versioduo/connect/README.md

# Copying
Anyone can use this public domain work without having to seek authorisation, no one can ever own it.
