versioduo/connect/hardware/hub/hub.pdf

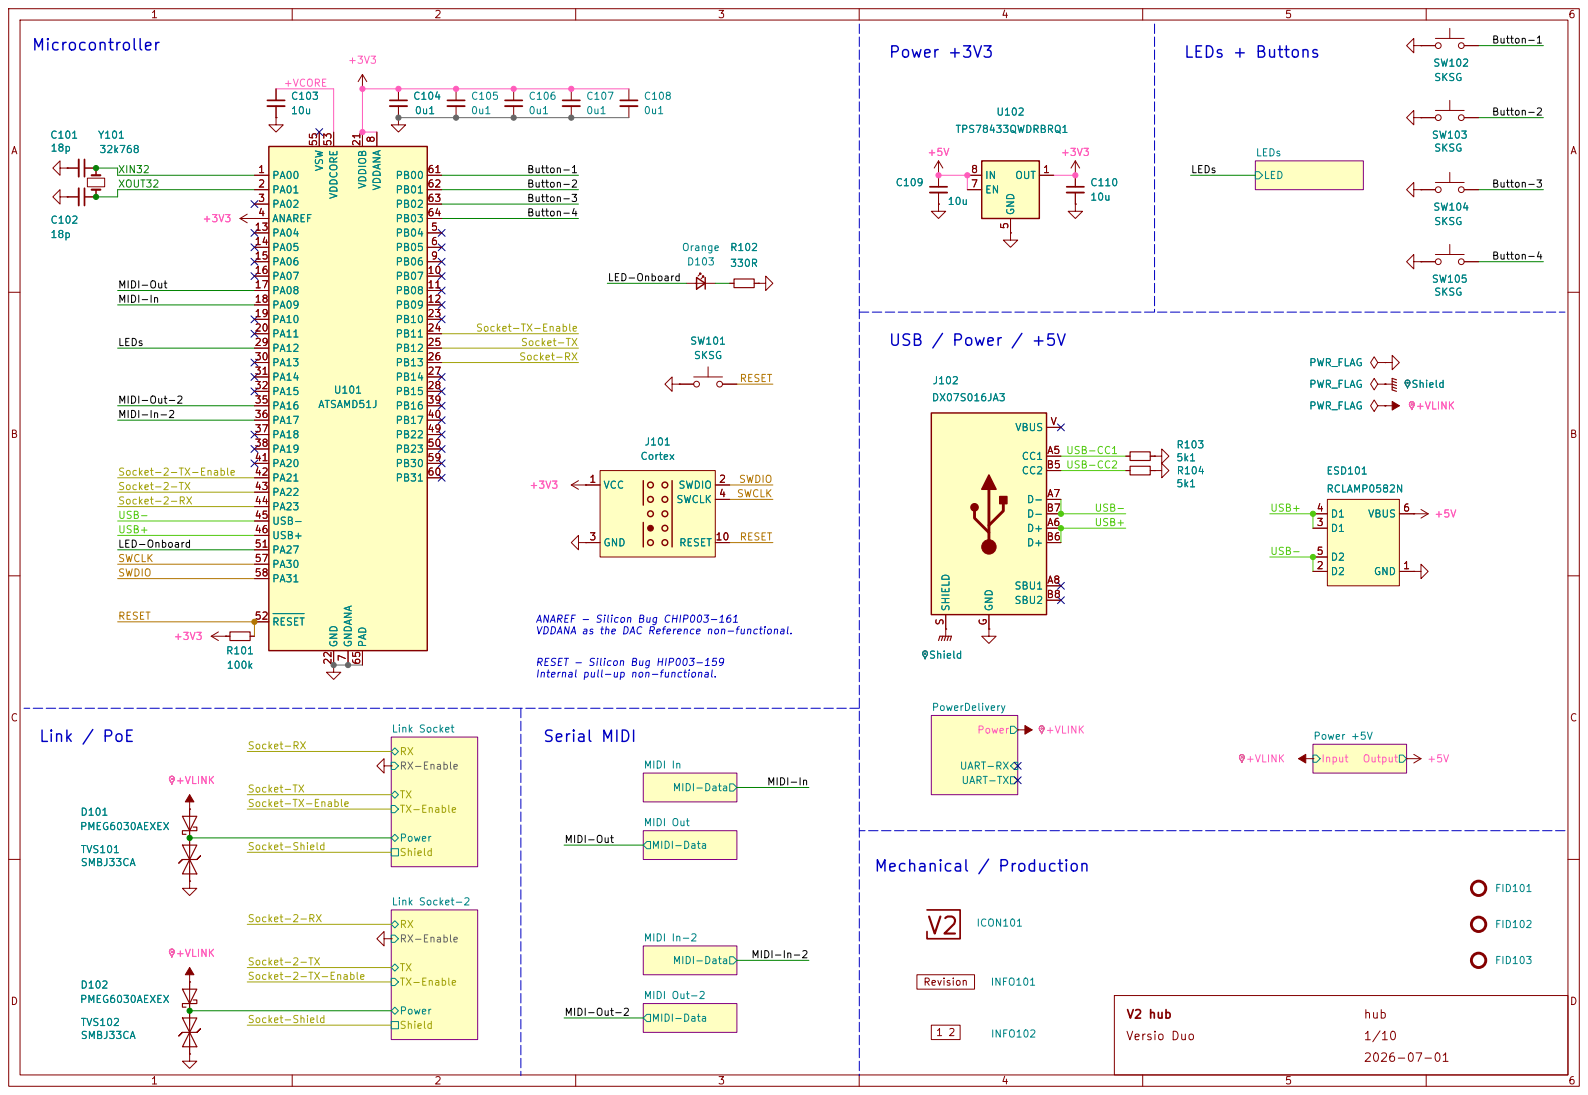
[picture p1: page 1]

RESET MIDI-In-2 MIDI-In

RESET SWDIO MIDI-Out-2 RESET MIDI-In-2

Internal pull-up non-functional. Link / PoE

Power UART-RX UART-TX PowerDelivery

Socket-Shield Socket-RX

Socket-Shield Socket-2-TX-Enable Socket-TX-Enable Socket-2-TX

TX-Enable Power Shield

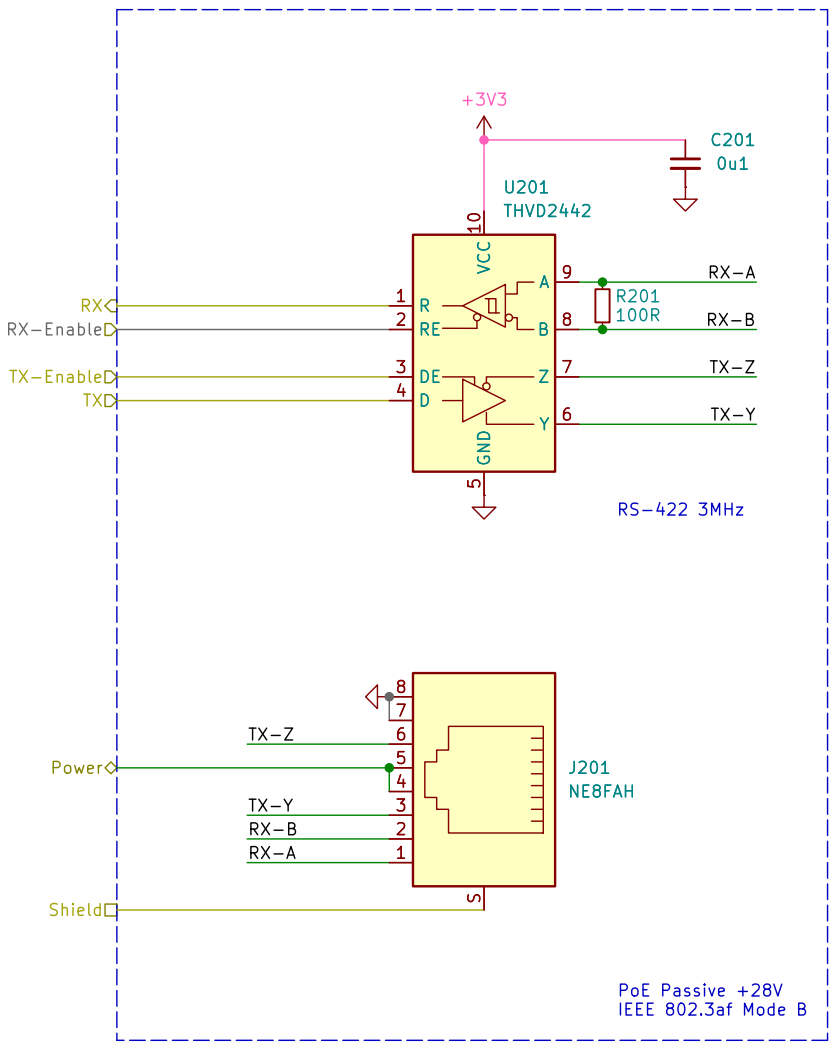
[picture p2: page 2]

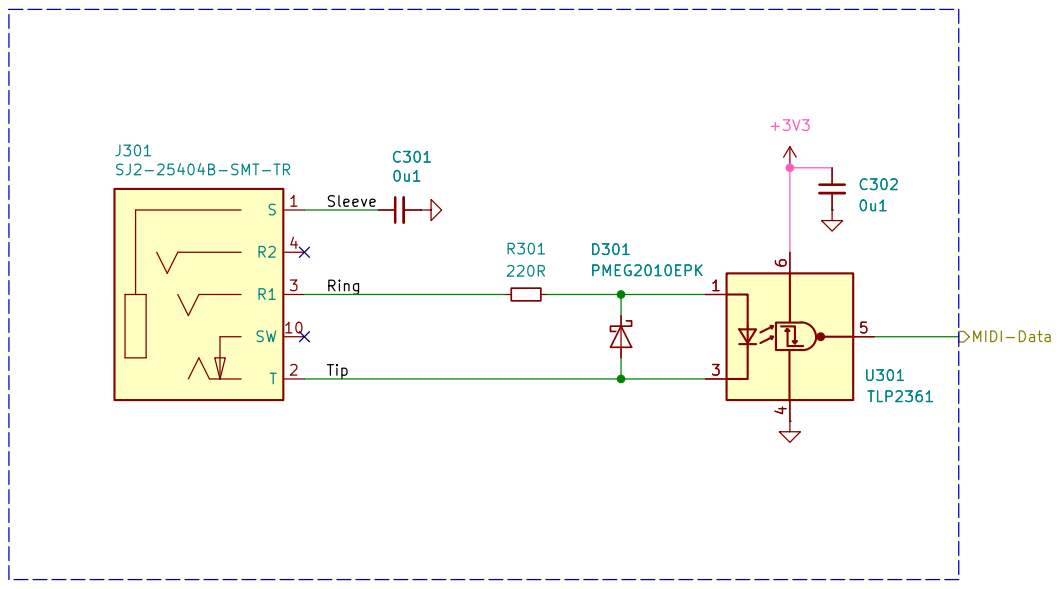
[picture p3: page 3]

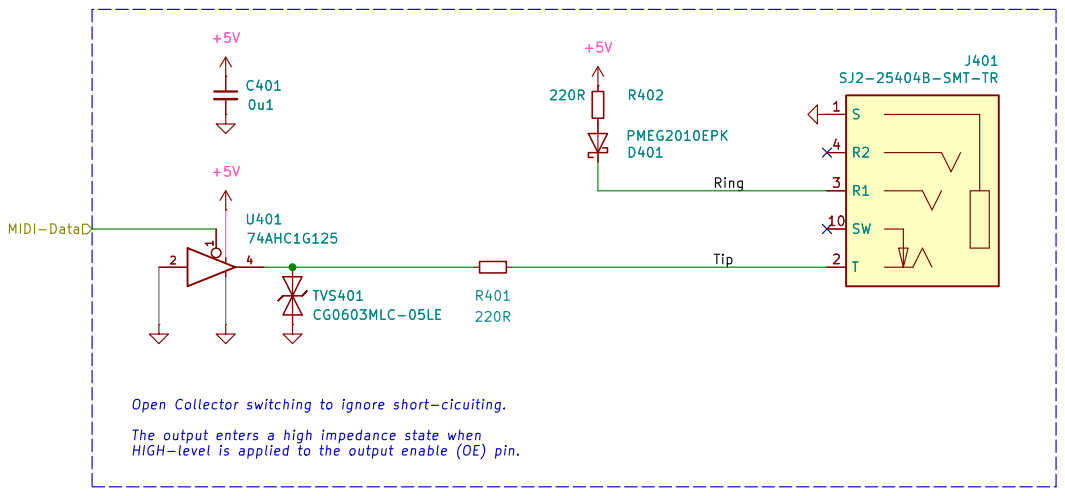
[picture p4: page 4]

Open Collector switching to ignore short-cicuiting. The output enters a high impedance state when HIGH-level is applied to the output enable (OE) pin. TVS401 CG0603MLC-05LE +5V +5V

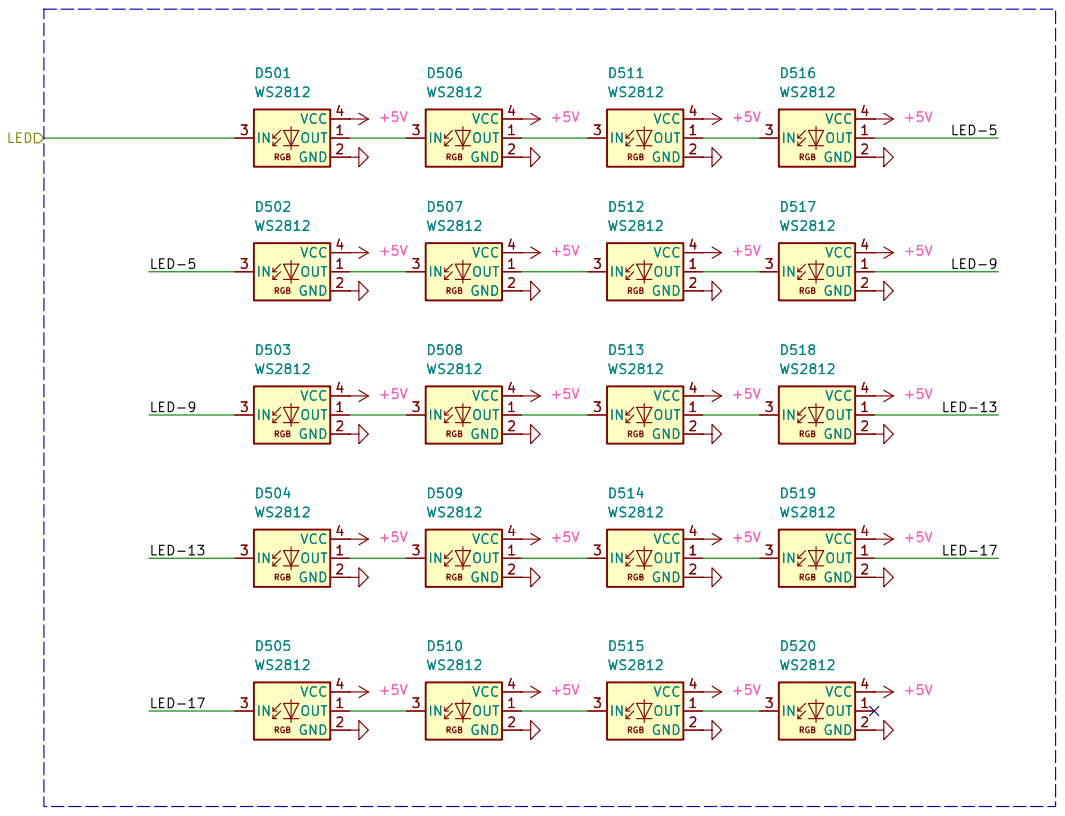
[picture p5: page 5]

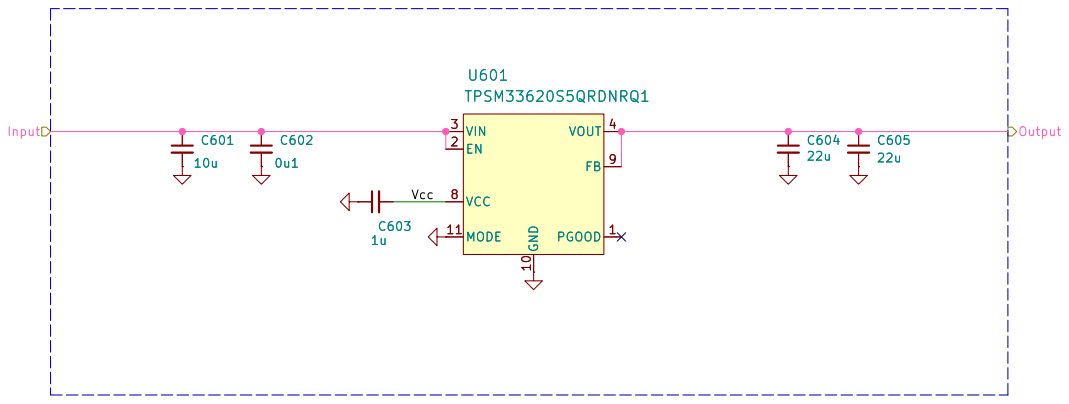
[picture p6: page 6]

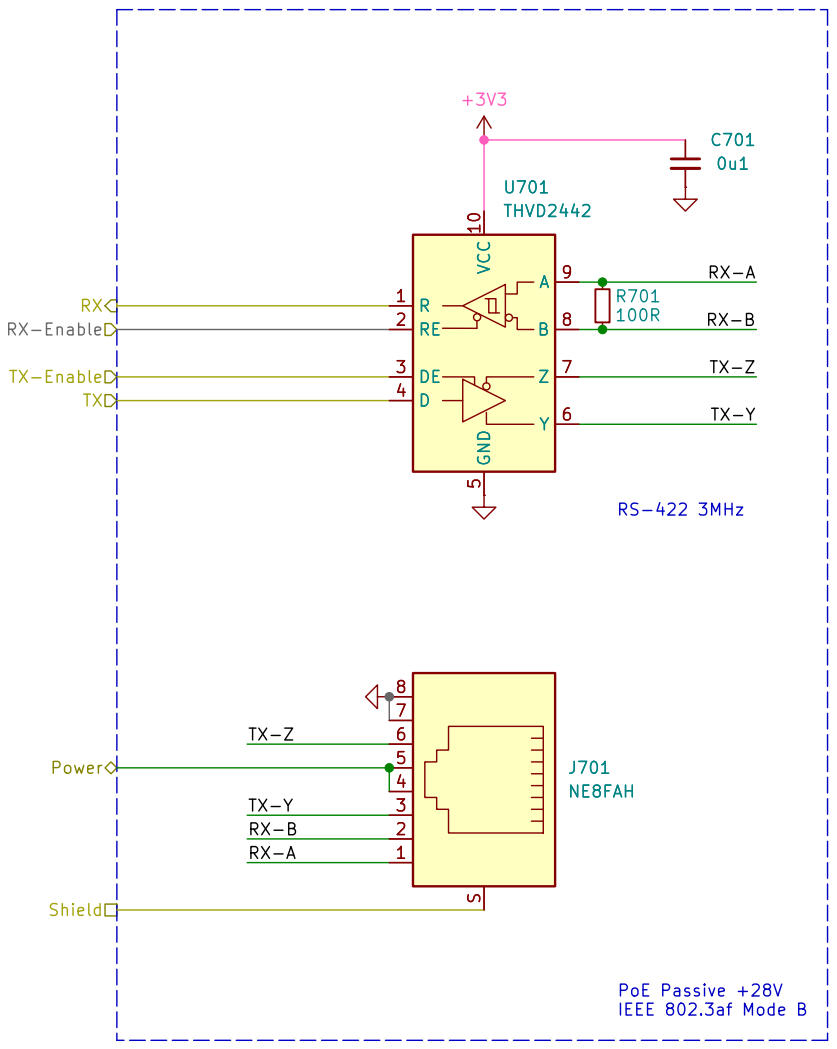
[picture p7: page 7]

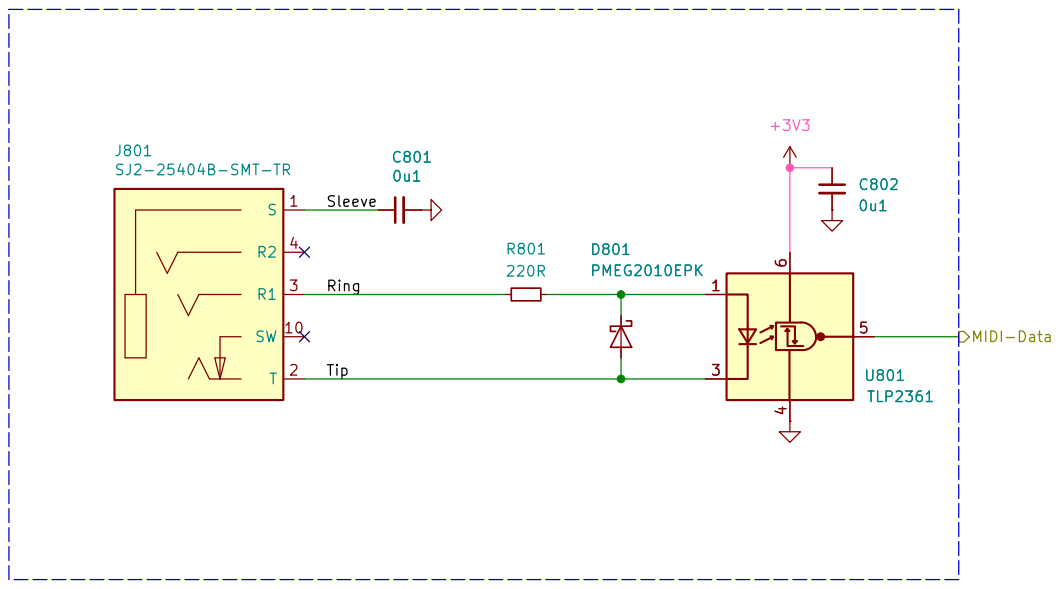
[picture p8: page 8]

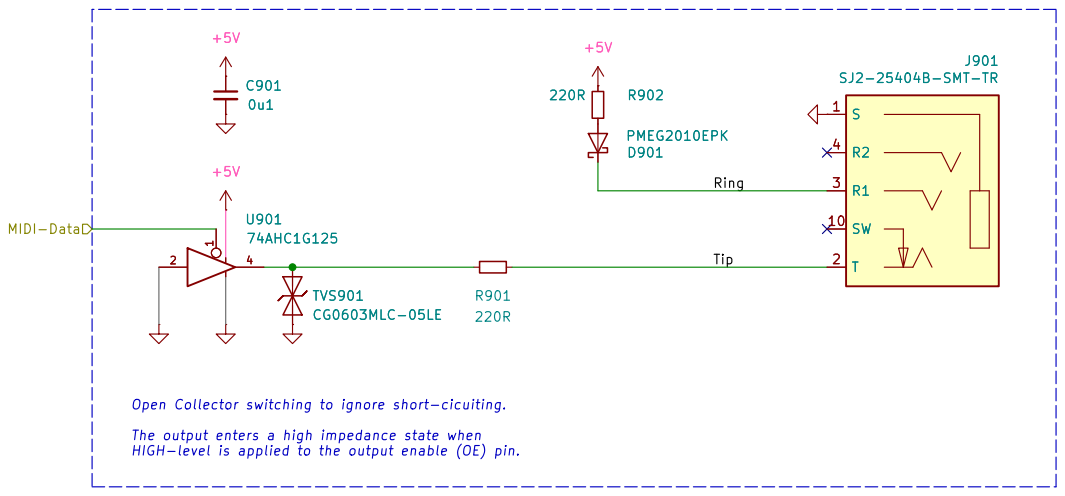
[picture p9: page 9]

Open Collector switching to ignore short-cicuiting. The output enters a high impedance state when HIGH-level is applied to the output enable (OE) pin. TVS901 CG0603MLC-05LE +5V +5V U901

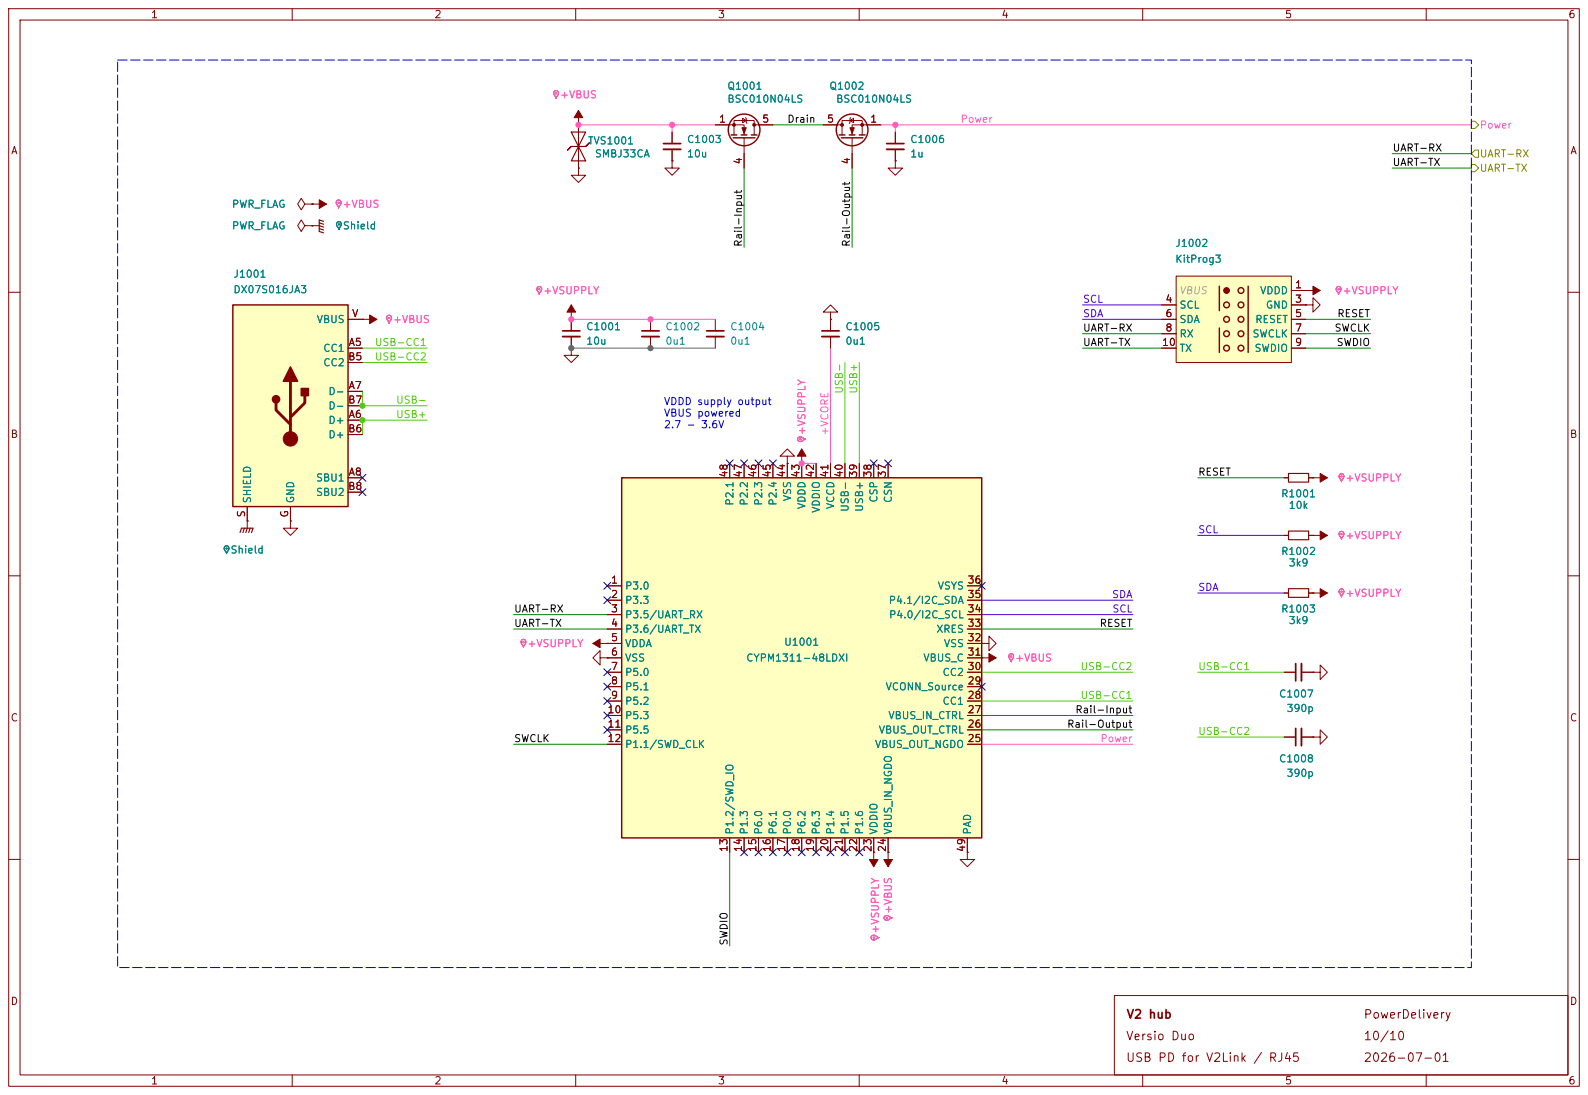
[picture p10: page 10]

PWR_FLAG +VBUS PWR_FLAG

SBU2 B8 GND
