versioduo/connect/hardware/plug/plug.pdf

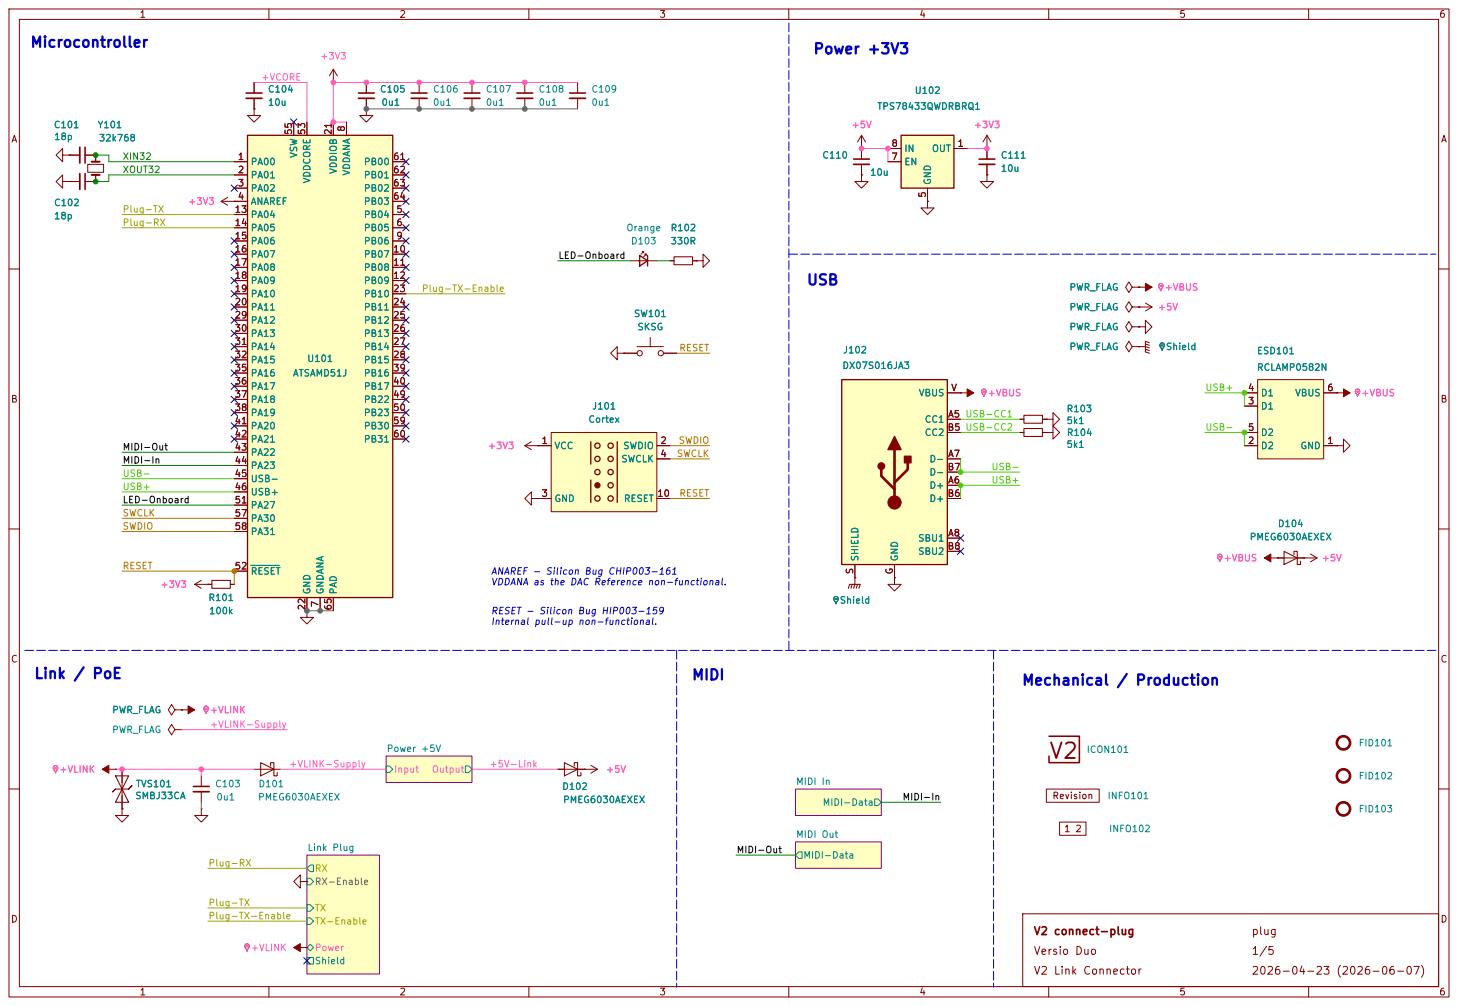
[picture p11: page 1]

Internal pull-up non-functional. ANAREF - Silicon Bug CHIP003-161

TX-Enable Power Shield

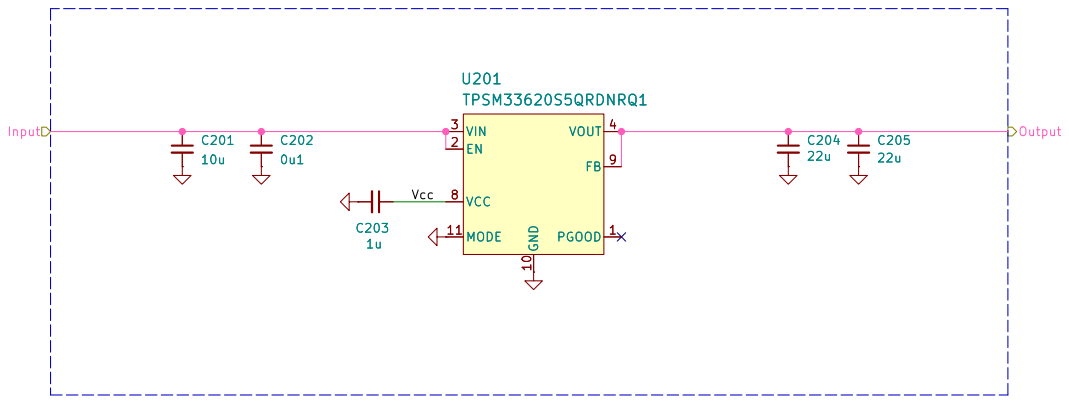
[picture p12: page 2]

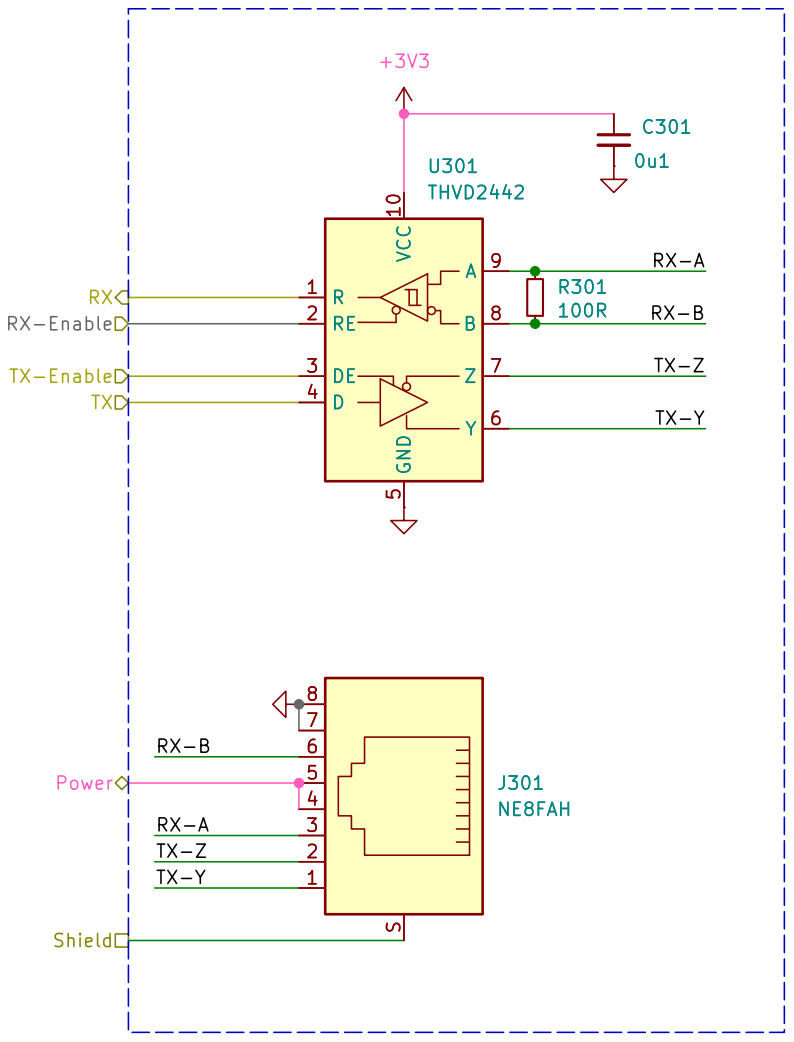
[picture p13: page 3]

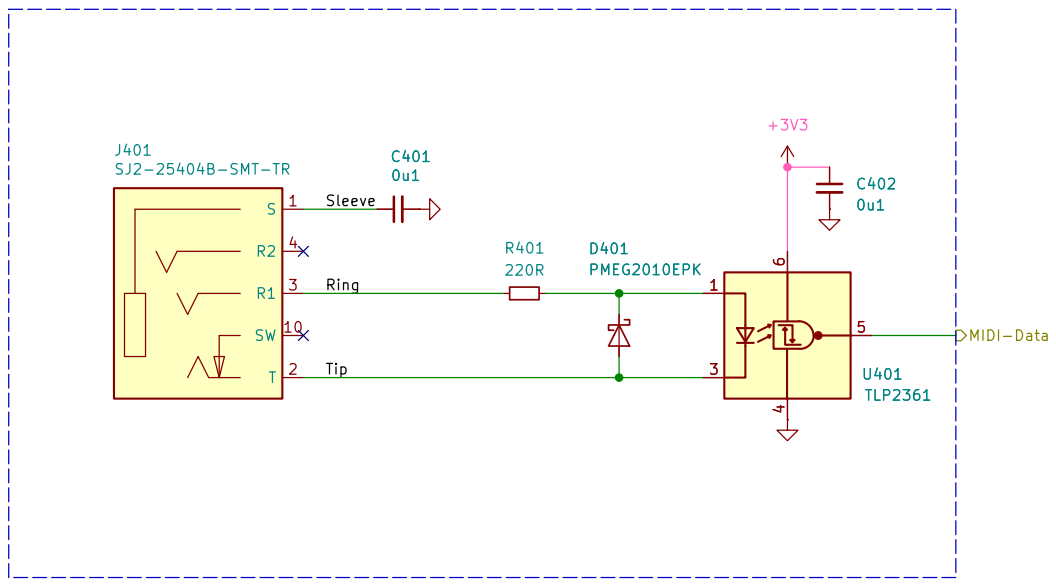
[picture p14: page 4]

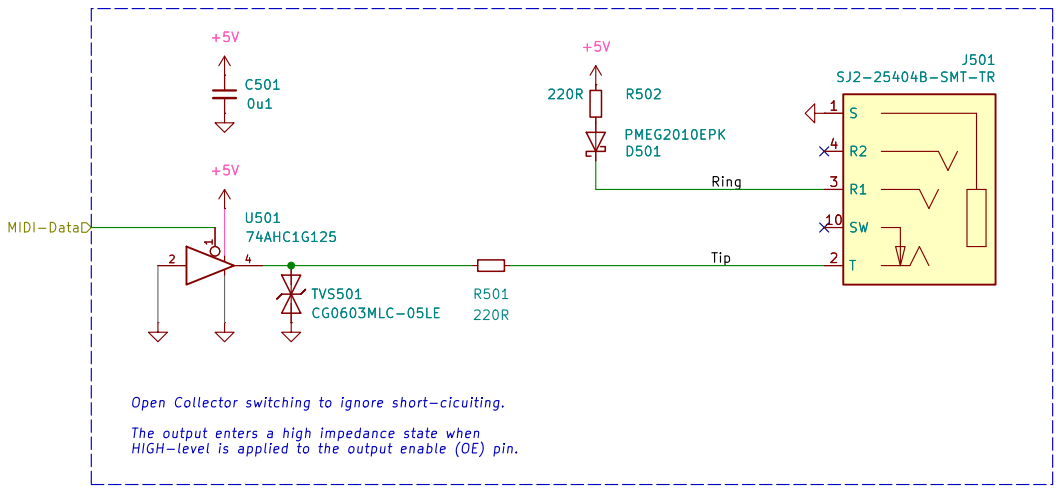
[picture p15: page 5]

Open Collector switching to ignore short-cicuiting. The output enters a high impedance state when HIGH-level is applied to the output enable (OE) pin. TVS501 CG0603MLC-05LE +5V +5V
