versioduo/connect/hardware/socket/socket.pdf

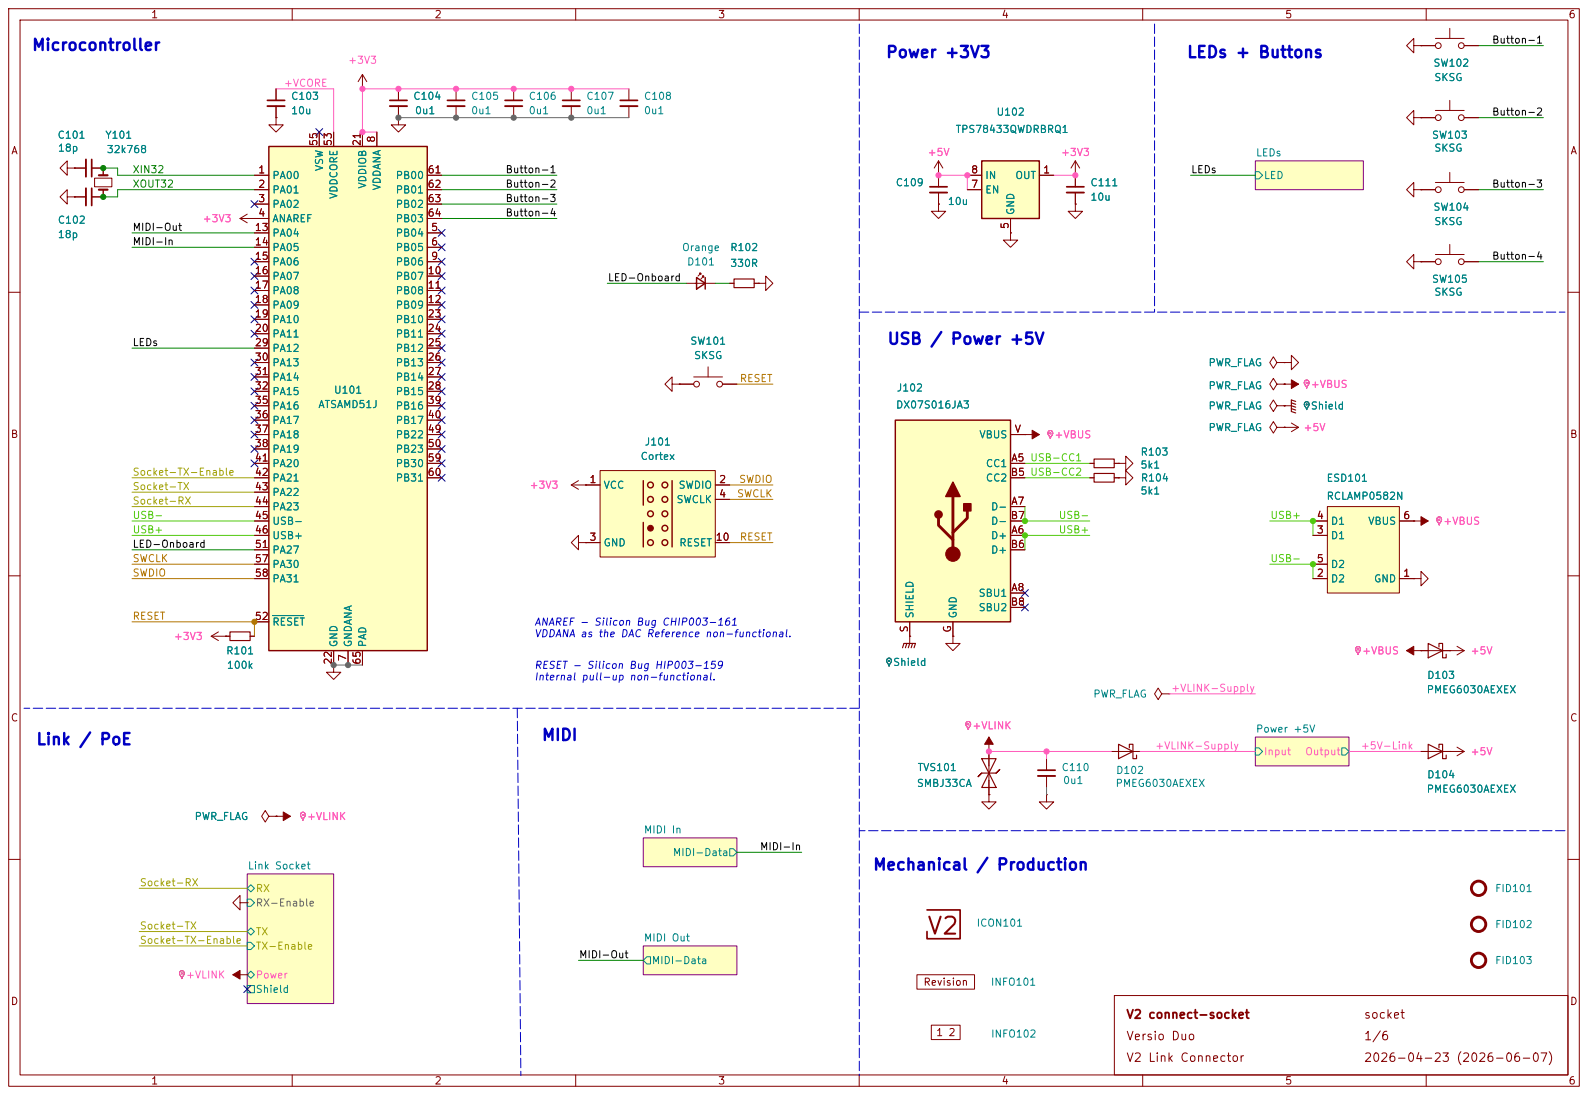
[picture p16: page 1]

+VLINK-Supply RESET MIDI-Out XOUT32

Internal pull-up non-functional. R101

MIDI RESET - Silicon Bug HIP003-159

socket MIDI-Data MIDI Out

TX-Enable Power Shield

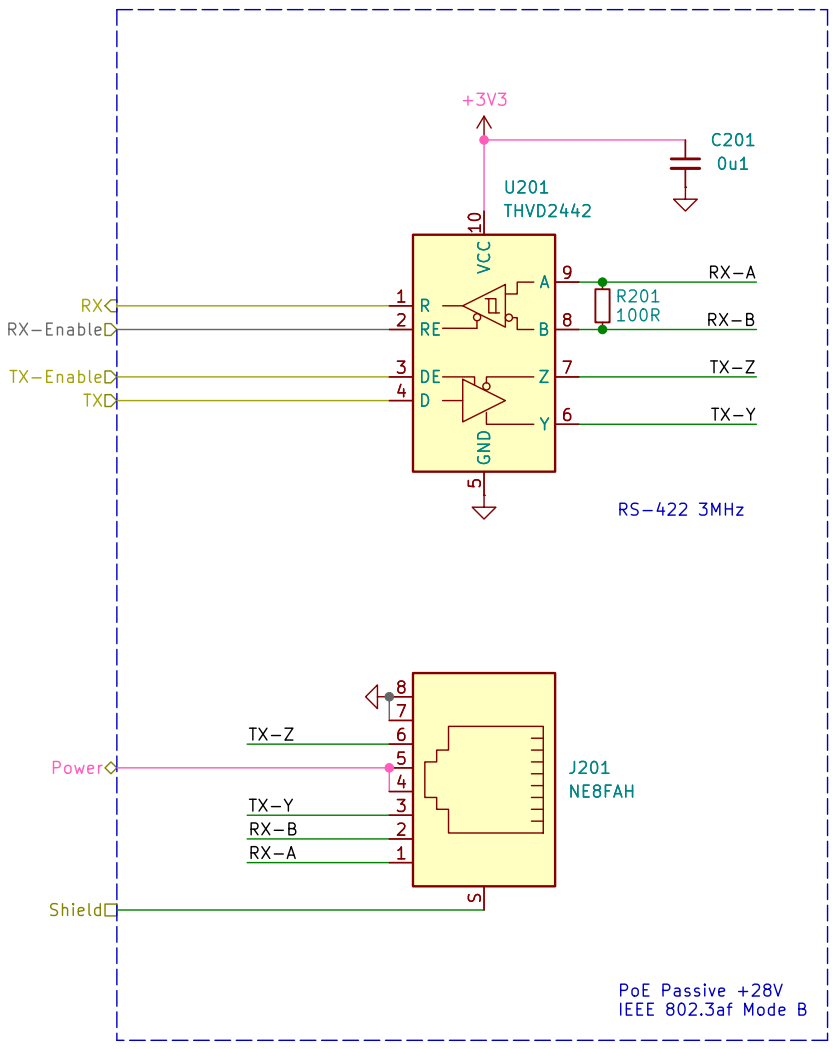
[picture p17: page 2]

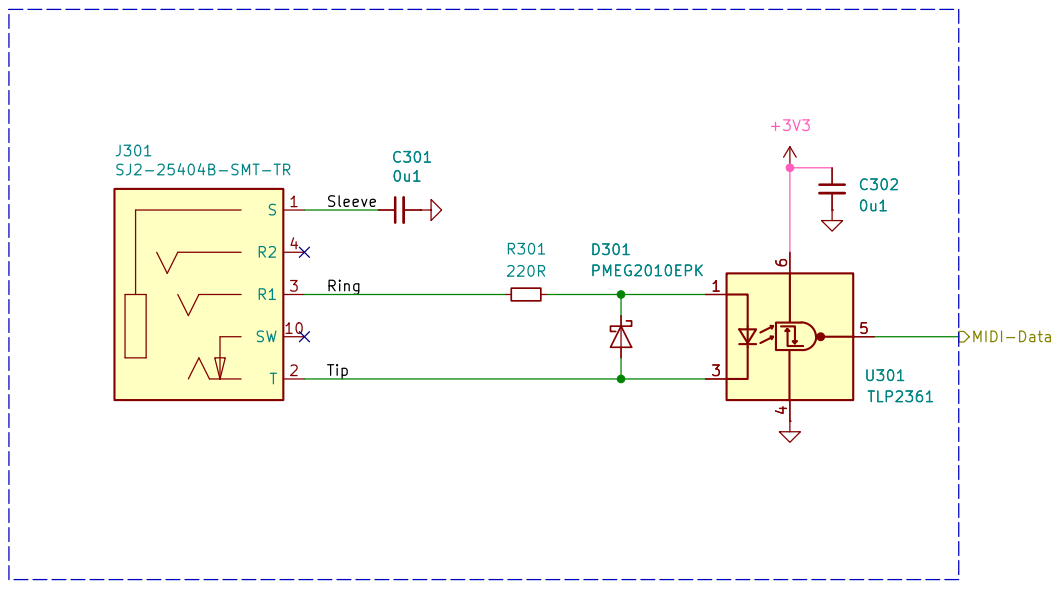
[picture p18: page 3]

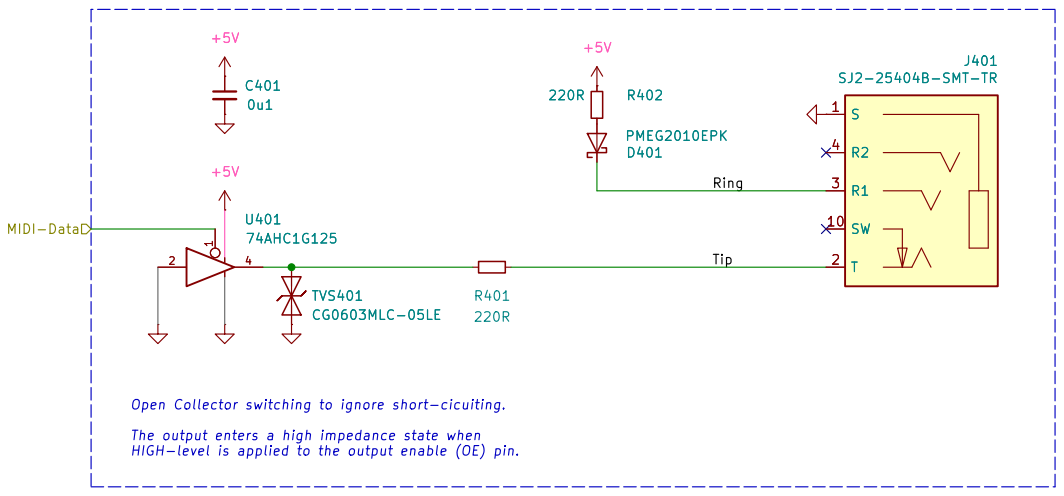
[picture p19: page 4]

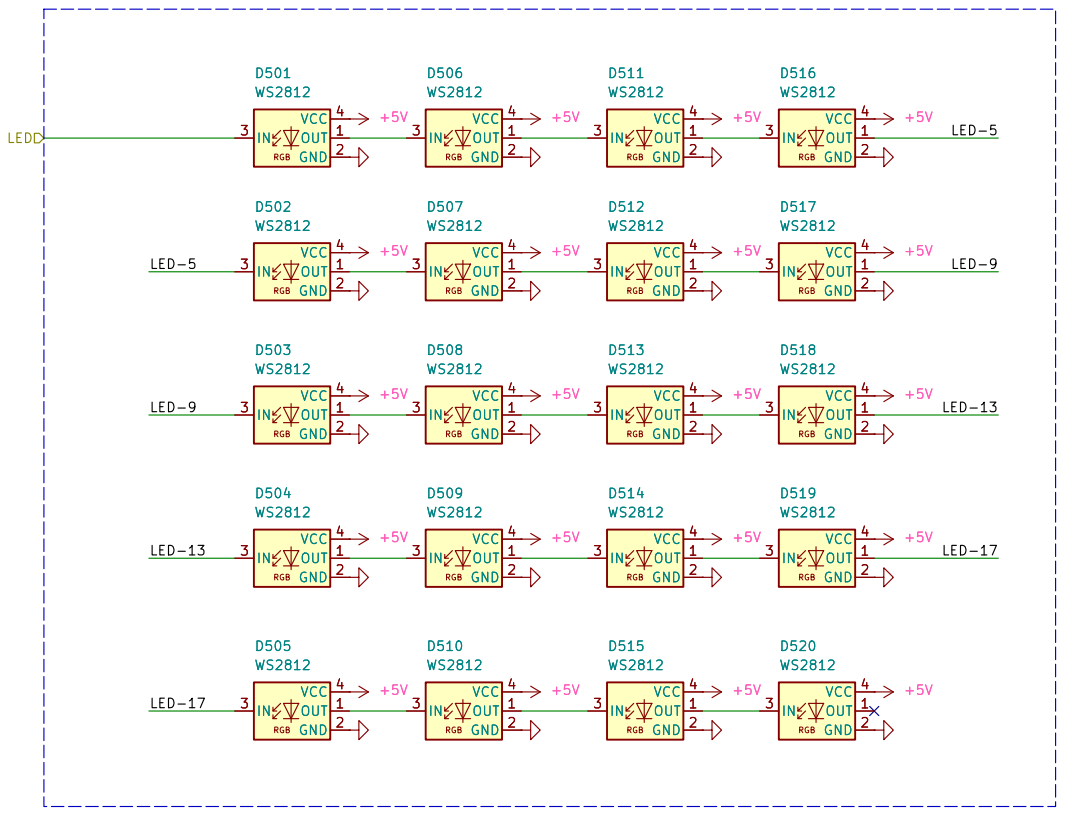
[picture p20: page 5]

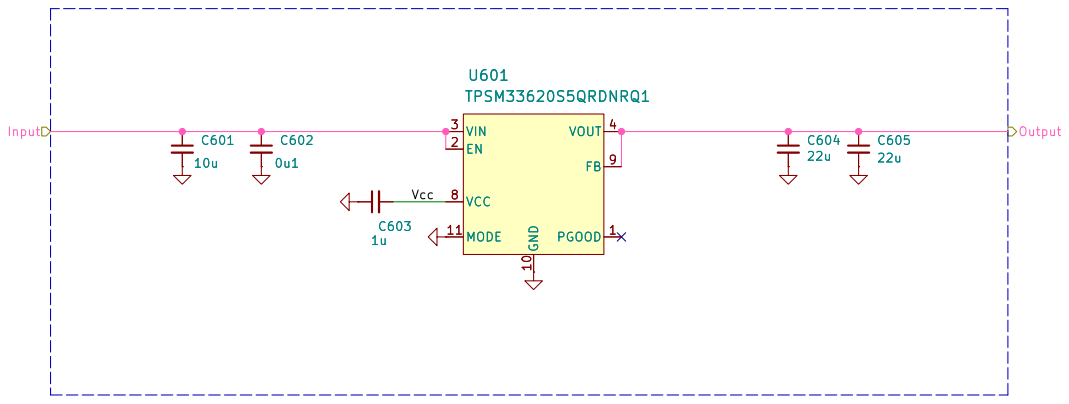
[picture p21: page 6]
