versioduo/connect/hardware/hub/hub.kicad_pcb

## KiCad design hardware/hub/hub.kicad_pcb (2026-08-01)

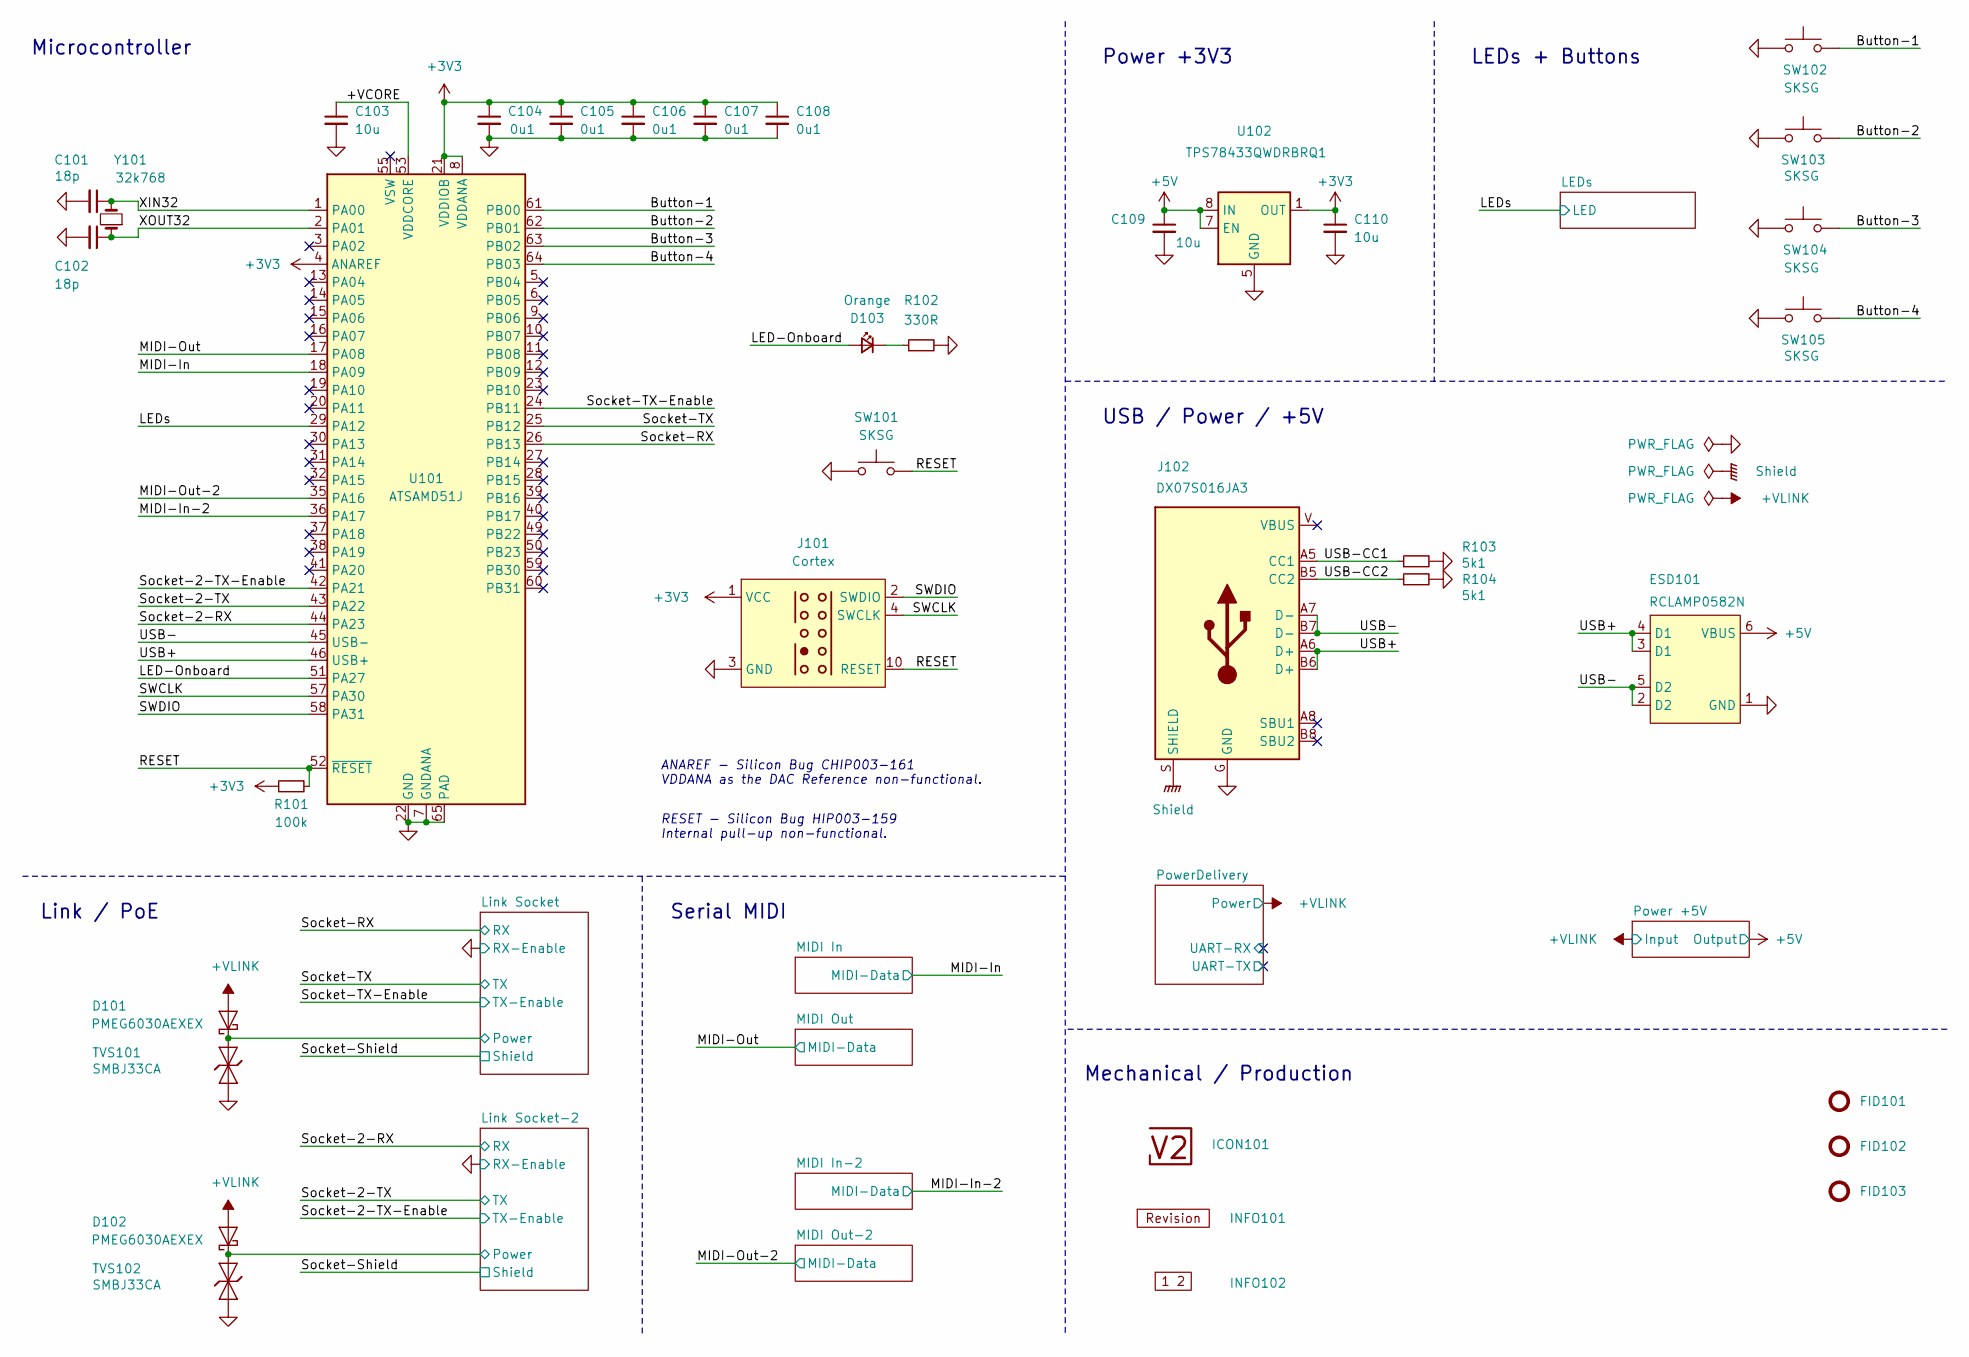
[picture p22: schematic hub.kicad_sch, V2 hub]

Parts:
C101, C102: 18p; C_1608; Rating 50V; Mouser 810-CGA3E2C0G1H180J
C103: 10u; C_1608; Rating 10V; Mouser 810-C1608X6S1A106M
C104, C105, C106, C107, C108: 0u1; C_1608; Rating 50V; Mouser 810-CGA3E2X7R1H104MA
C109, C110: 10u; C_2012; Rating 25V; Mouser 810-C2012X5R1E106K
D101, D102: PMEG6030AEXEX; D_SOD-123HP; Rating 60V; Mouser 771-PMEG6030AEXEX
D103: Orange; LED_1608; Rating 605nm; Mouser 755-SML-D12D1WT86
ESD101: RCLAMP0582N; SLP1210N6; Rating 20kV; Mouser 947-RCLAMP0582N.TCT
FID101, FID102, FID103: Fiducial_Paste; Fiducial_0.5mm_Mask1mm_Paste
ICON101: V2-logo; Logo_Small
INFO101: Revision
INFO102: Layer_Numbers-4
J101: Cortex
J102: DX07S016JA3; JAE_DX07S016JA3; Rating USB2.0; Mouser 656-DX07S016JA3R1500
R101: 100k; R_1608; Rating 100mW; Mouser 71-CRCW0603100KFKEAC
R102: 330R; R_1608; Rating 100mW; Mouser 71-CRCW0603330RFKEAC
R103, R104: 5k1; R_1608; Rating 100mW; Mouser 71-CRCW06035K10FKEAC
SW101, SW102, SW103, SW104, SW105: SKSG; Rating 1.6N; Mouser 688-SKSGACE010
TVS101, TVS102: SMBJ33CA; D_SMB; Rating 33V; Mouser 652-SMBJ33CA-Q
U101: ATSAMD51J; QFN-64-1EP_9x9mm_P0.5mm_EP4.8x4.8mm_ThermalVias; Rating Cortex-M4F; Mouser 556-ATSAMD51J19AMU
U102: TPS78433QWDRBRQ1; VSON-8-1_3x3mm_P0.65_EP1.65x2.4mm; Rating 300mA; Mouser 595-TPS78433QWDRBRQ1
Y101: 32k768; Crystal_SMD_3215-2Pin_3.2x1.5mm; Rating 10ppm; Mouser 815-ABS0716632.768KT

Connections:
+3V3: C104.1, C105.1, C106.1, C107.1, C108.1, C110.1, J101.1 (VCC), R101.1, U101.4 (ANAREF), U101.8 (VDDANA), U101.21 (VDDIOB), U101.34 (VDDIO), U101.48 (VDDIO), U101.56 (VDDIO), U102.1 (OUT); also elsewhere on the board
+5V: C109.1, ESD101.6 (VBUS), U102.7 (EN), U102.8 (IN); also elsewhere on the board
/+VCORE: C103.1, U101.53 (VDDCORE)
/+VLINK: D101.2 (A), D102.2 (A); also elsewhere on the board
/Button-1: SW102.2, U101.61 (PB00)
/Button-2: SW103.2, U101.62 (PB01)
/Button-3: SW104.2, U101.63 (PB02)
/Button-4: SW105.2, U101.64 (PB03)
/LED-Onboard: D103.2 (A), U101.51 (PA27)
/LEDs: U101.29 (PA12); also elsewhere on the board
/Link Socket-2/Power: D102.1 (K), TVS102.2 (A); also elsewhere on the board
/Link Socket/Power: D101.1 (K), TVS101.2 (A); also elsewhere on the board
/MIDI-In: U101.18 (PA09); also elsewhere on the board
/MIDI-In-2: U101.36 (PA17); also elsewhere on the board
/MIDI-Out: U101.17 (PA08); also elsewhere on the board
/MIDI-Out-2: U101.35 (PA16); also elsewhere on the board
/RESET: J101.10 (RESET), R101.2, SW101.2, U101.52 (~RESET)
/SWCLK: J101.4 (SWCLK), U101.57 (PA30)
/SWDIO: J101.2 (SWDIO), U101.58 (PA31)
/Shield: J102.S (SHIELD)
/Socket-2-RX: U101.44 (PA23); also elsewhere on the board
/Socket-2-TX: U101.43 (PA22); also elsewhere on the board
/Socket-2-TX-Enable: U101.42 (PA21); also elsewhere on the board
/Socket-RX: U101.26 (PB13); also elsewhere on the board
/Socket-TX: U101.25 (PB12); also elsewhere on the board
/Socket-TX-Enable: U101.24 (PB11); also elsewhere on the board
/USB+: ESD101.3 (D1), ESD101.4 (D1), J102.A6 (D+), J102.B6 (D+), U101.46 (USB+)
/USB-: ESD101.2 (D2), ESD101.5 (D2), J102.A7 (D-), J102.B7 (D-), U101.45 (USB-)
/USB-CC1: J102.A5 (CC1), R103.1
/USB-CC2: J102.B5 (CC2), R104.1
/XIN32: C101.1, U101.1 (PA00), Y101.2
/XOUT32: C102.1, U101.2 (PA01), Y101.1
GND: C101.2, C102.2, C103.2, C104.2, C105.2, C106.2, C107.2, C108.2, C109.2, C110.2, ESD101.1 (GND), J101.3 (GND), J101.5 (GND), J102.G (GND), R102.2, R103.2, R104.2, SW101.1, SW102.1, SW103.1, SW104.1, SW105.1, TVS101.1 (K), TVS102.1 (K), U101.7 (GNDANA), U101.22 (GND), U101.33 (GND), U101.47 (GND), U101.54 (GND), U101.65 (PAD), U102.5 (GND), U102.9 (GND); also elsewhere on the board
unnamed: D103.1 (K), R102.1

Notes on the sheet:
ANAREF - Silicon Bug CHIP003-161 VDDANA as the DAC Reference non-functional.
Link / PoE
RESET - Silicon Bug HIP003-159 Internal pull-up non-functional.
LEDs + Buttons
Serial MIDI
Power +3V3
Mechanical / Production
Microcontroller
USB / Power / +5V

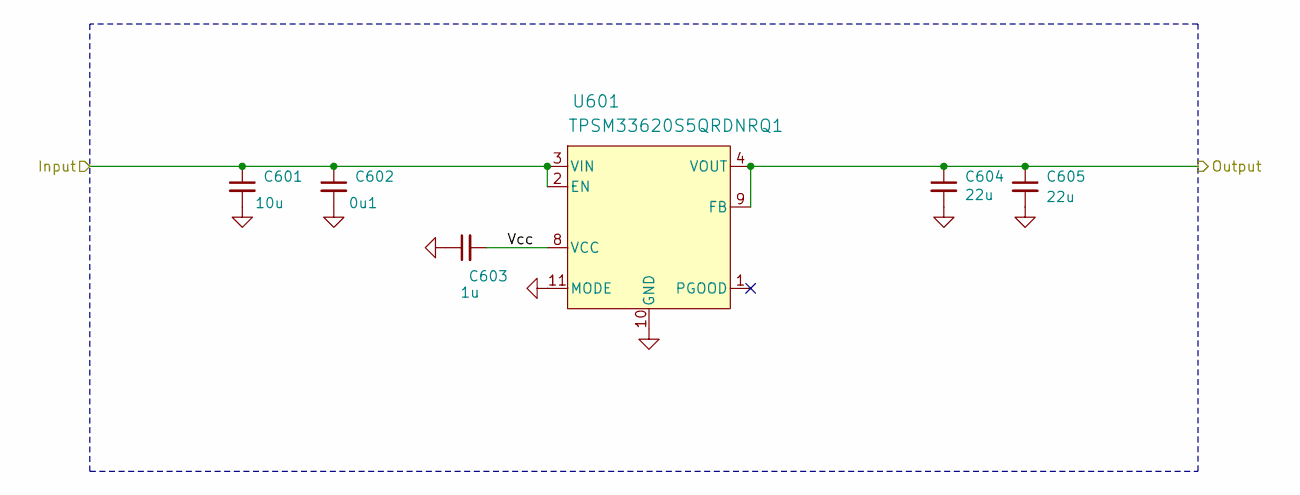
[picture p23: schematic PowerSupply.kicad_sch, V2 hub]

Parts:
C601: 10u; C_3225; Rating 50V; Mouser 810-CNC6P1X7R1H106K2
C602: 0u1; C_1608; Rating 50V; Mouser 810-CGA3E2X7R1H104MA
C603: 1u; C_1608; Rating 50V; Mouser 810-CGA3E3X7R1H105K0
C604, C605: 22u; C_3225; Rating 25V; Mouser 810-CGA6P3X7R1E226M5
U601: TPSM33620S5QRDNRQ1; QFN-11; Rating 2A; Mouser 595-SM33620S5QRDNRQ1

Connections:
+5V: C604.1, C605.1, U601.4 (VOUT), U601.9 (FB); also elsewhere on the board
/+VLINK: C601.1, C602.1, U601.2 (EN), U601.3 (VIN); also elsewhere on the board
/Power +5V/Vcc: C603.2, U601.8 (VCC)
GND: C601.2, C602.2, C603.1, C604.2, C605.2, U601.10 (GND), U601.11 (MODE); also elsewhere on the board

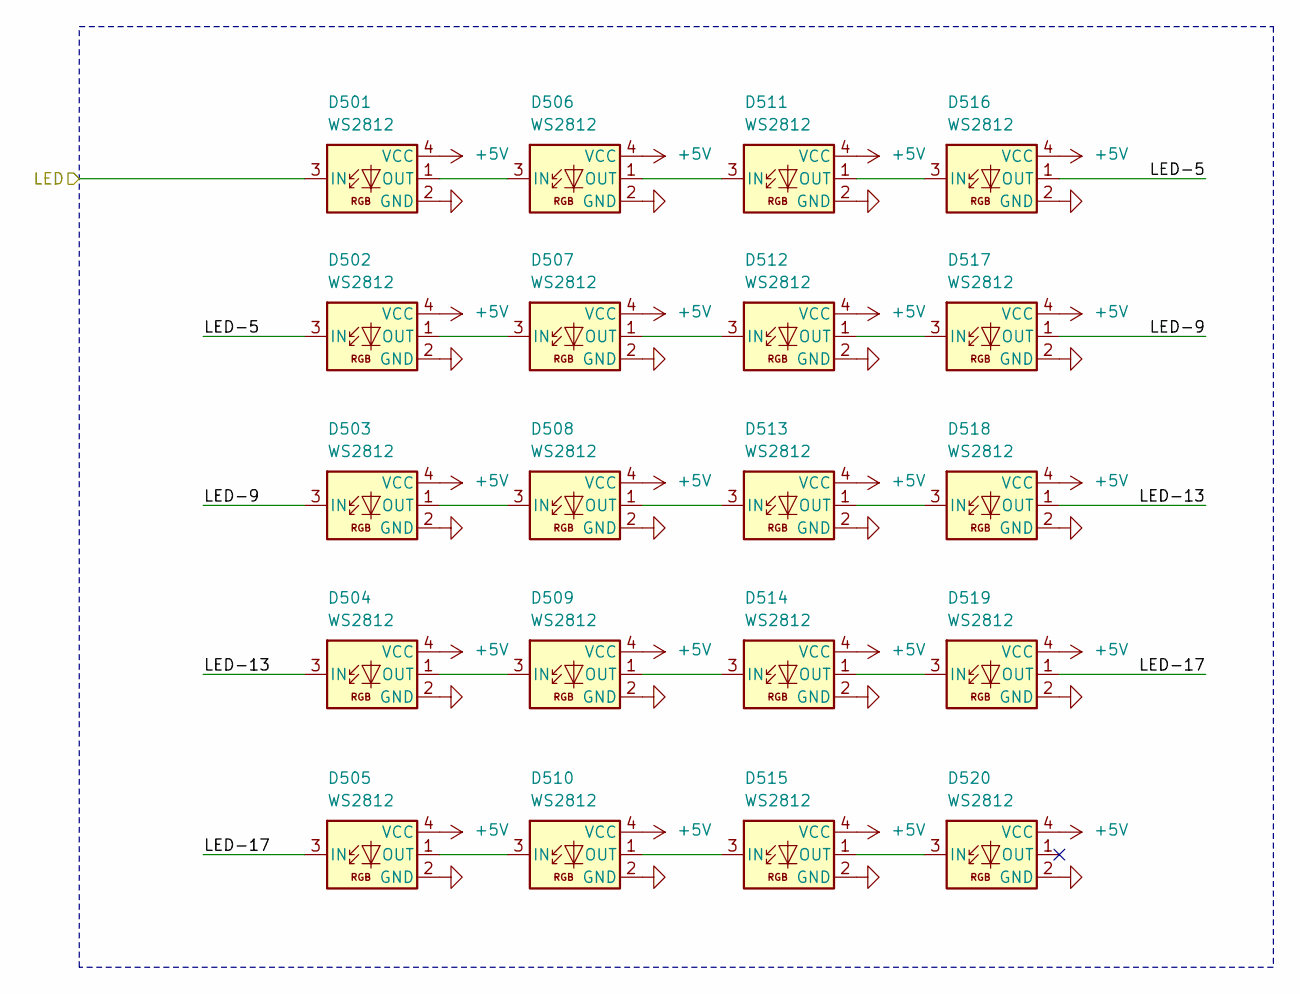
[picture p24: schematic LEDs.kicad_sch, V2 hub]

Parts:
D501, D502, D503, D504, D505, D506, D507, D508, D509, D510, D511, D512, D513, D514, D515, D516, D517, D518, D519, D520: WS2812; WS2812-2020; Rating 15mA; LCSC C965555

Connections:
+5V: D501.4 (VCC), D502.4 (VCC), D503.4 (VCC), D504.4 (VCC), D505.4 (VCC), D506.4 (VCC), D507.4 (VCC), D508.4 (VCC), D509.4 (VCC), D510.4 (VCC), D511.4 (VCC), D512.4 (VCC), D513.4 (VCC), D514.4 (VCC), D515.4 (VCC), D516.4 (VCC), D517.4 (VCC), D518.4 (VCC), D519.4 (VCC), D520.4 (VCC); also elsewhere on the board
/LEDs: D501.3 (IN); also elsewhere on the board
/LEDs/LED-5: D502.3 (IN), D516.1 (OUT)
/LEDs/LED-9: D503.3 (IN), D517.1 (OUT)
/LEDs/LED-13: D504.3 (IN), D518.1 (OUT)
/LEDs/LED-17: D505.3 (IN), D519.1 (OUT)
GND: D501.2 (GND), D502.2 (GND), D503.2 (GND), D504.2 (GND), D505.2 (GND), D506.2 (GND), D507.2 (GND), D508.2 (GND), D509.2 (GND), D510.2 (GND), D511.2 (GND), D512.2 (GND), D513.2 (GND), D514.2 (GND), D515.2 (GND), D516.2 (GND), D517.2 (GND), D518.2 (GND), D519.2 (GND), D520.2 (GND); also elsewhere on the board
unnamed: D501.1 (OUT), D506.3 (IN)
unnamed: D502.1 (OUT), D507.3 (IN)
unnamed: D503.1 (OUT), D508.3 (IN)
unnamed: D504.1 (OUT), D509.3 (IN)
unnamed: D505.1 (OUT), D510.3 (IN)
unnamed: D506.1 (OUT), D511.3 (IN)
unnamed: D507.1 (OUT), D512.3 (IN)
unnamed: D508.1 (OUT), D513.3 (IN)
unnamed: D509.1 (OUT), D514.3 (IN)
unnamed: D510.1 (OUT), D515.3 (IN)
unnamed: D511.1 (OUT), D516.3 (IN)
unnamed: D512.1 (OUT), D517.3 (IN)
unnamed: D513.1 (OUT), D518.3 (IN)
unnamed: D514.1 (OUT), D519.3 (IN)
unnamed: D515.1 (OUT), D520.3 (IN)

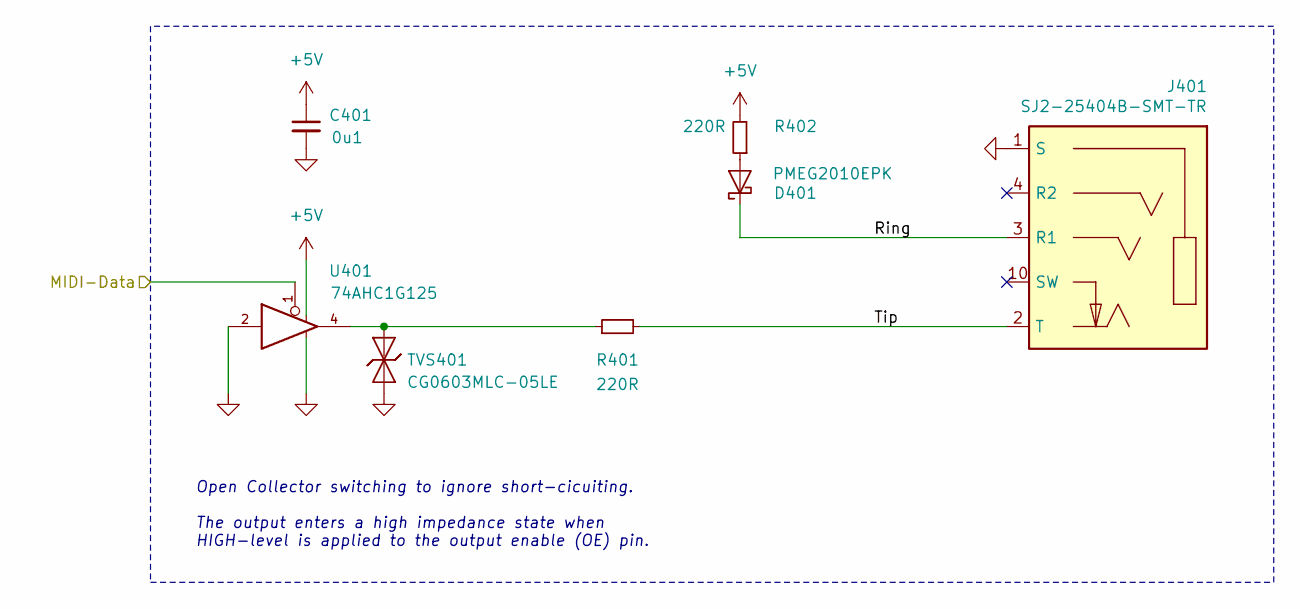
[picture p25: schematic MIDIOut.kicad_sch, V2 hub]

Parts:
C401: 0u1; C_1608; Rating 50V; Mouser 810-CGA3E2X7R1H104MA
D401: PMEG2010EPK; D_SOD-1608; Rating 20V; Mouser 771-PMEG2010EPK
J401: SJ2-25404B-SMT-TR; CUI_SJ2-25404B-SMT-TR; Rating 2.5mm; Mouser 490-SJ2-25404BSMT-TR
R401, R402: 220R; R_1608; Rating 330mW; Mouser 71-CRCW0603220RFKEAH
TVS401: CG0603MLC-05LE; D_1608; Rating 5V; Mouser 652-CG0603MLC-05LE
U401: 74AHC1G125; SOT-23-5; Rating 8mA; Mouser 595-SN74AHC1G125DBVR

Connections:
+5V: C401.1, R402.2, U401.5; also elsewhere on the board
/MIDI Out/Ring: D401.1 (K), J401.3 (R1)
/MIDI Out/Tip: J401.2 (T), R401.2
/MIDI-Out: U401.1; also elsewhere on the board
GND: C401.2, J401.1 (S), TVS401.1 (K), U401.2, U401.3; also elsewhere on the board
unnamed: D401.2 (A), R402.1
unnamed: R401.1, TVS401.2 (A), U401.4

Parts of its further copies:
C901: 0u1; C_1608; Rating 50V; Mouser 810-CGA3E2X7R1H104MA
D901: PMEG2010EPK; D_SOD-1608; Rating 20V; Mouser 771-PMEG2010EPK
J901: SJ2-25404B-SMT-TR; CUI_SJ2-25404B-SMT-TR; Rating 2.5mm; Mouser 490-SJ2-25404BSMT-TR
R901, R902: 220R; R_1608; Rating 330mW; Mouser 71-CRCW0603220RFKEAH
TVS901: CG0603MLC-05LE; D_1608; Rating 5V; Mouser 652-CG0603MLC-05LE
U901: 74AHC1G125; SOT-23-5; Rating 8mA; Mouser 595-SN74AHC1G125DBVR

Connections of its further copies:
+5V: C901.1, R902.2, U901.5; also elsewhere on the board
/MIDI Out-2/Ring: D901.1 (K), J901.3 (R1)
/MIDI Out-2/Tip: J901.2 (T), R901.2
/MIDI-Out-2: U901.1; also elsewhere on the board
GND: C901.2, J901.1 (S), TVS901.1 (K), U901.2, U901.3; also elsewhere on the board
unnamed: D901.2 (A), R902.1
unnamed: R901.1, TVS901.2 (A), U901.4

Notes on the sheet:
 Open Collector switching to ignore short-cicuiting. The output enters a high impedance state when HIGH-level is applied to the output enable (OE) pin.

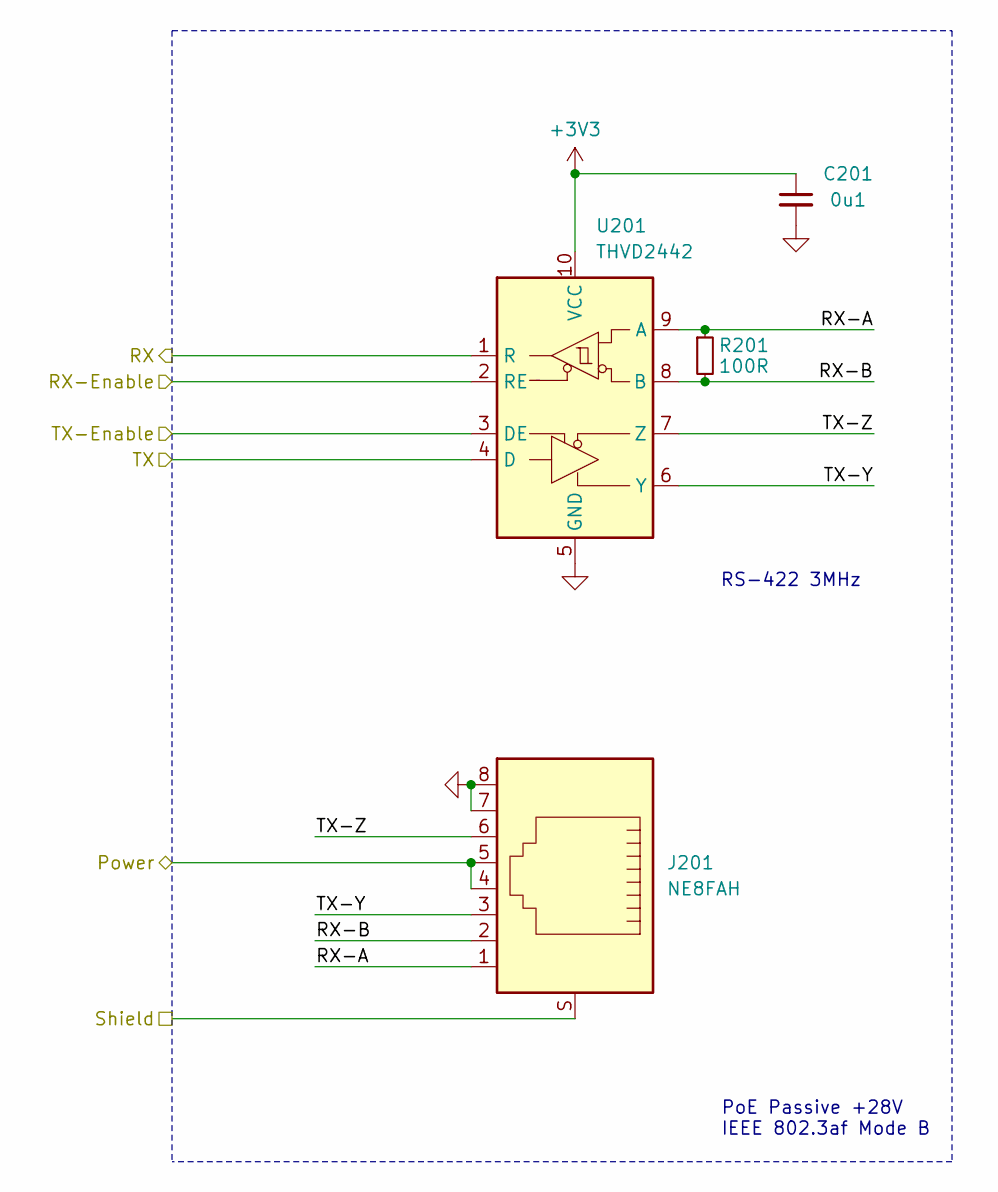
[picture p26: schematic LinkSocket.kicad_sch, V2 hub]

Parts:
C201: 0u1; C_1608; Rating 50V; Mouser 810-CGA3E2X7R1H104MA
J201: NE8FAH; Rating CAT5e; Mouser 568-NE8FAH
R201: 100R; R_1608; Rating 330mW; Mouser 71-CRCW0603100RFKEAH
U201: THVD2442; VSON-10-4-1EP_3x3mm_P0.5mm_EP1.65x2.4mm_ThermalVias; Rating 20Mbps; Mouser 595-THVD2442DRCR

Connections:
+3V3: C201.1, U201.10 (VCC); also elsewhere on the board
/Link Socket/Power: J201.4, J201.5; also elsewhere on the board
/Link Socket/RX-A: J201.1, R201.1, U201.9 (A)
/Link Socket/RX-B: J201.2, R201.2, U201.8 (B)
/Link Socket/TX-Y: J201.3, U201.6 (Y)
/Link Socket/TX-Z: J201.6, U201.7 (Z)
/Socket-RX: U201.1 (R); also elsewhere on the board
/Socket-Shield: J201.S; also elsewhere on the board
/Socket-TX: U201.4 (D); also elsewhere on the board
/Socket-TX-Enable: U201.3 (DE); also elsewhere on the board
GND: C201.2, J201.7, J201.8, U201.2 (RE), U201.5 (GND), U201.11 (GND); also elsewhere on the board

Parts of its further copies:
C701: 0u1; C_1608; Rating 50V; Mouser 810-CGA3E2X7R1H104MA
J701: NE8FAH; Rating CAT5e; Mouser 568-NE8FAH
R701: 100R; R_1608; Rating 330mW; Mouser 71-CRCW0603100RFKEAH
U701: THVD2442; VSON-10-4-1EP_3x3mm_P0.5mm_EP1.65x2.4mm_ThermalVias; Rating 20Mbps; Mouser 595-THVD2442DRCR

Connections of its further copies:
+3V3: C701.1, U701.10 (VCC); also elsewhere on the board
/Link Socket-2/Power: J701.4, J701.5; also elsewhere on the board
/Link Socket-2/RX-A: J701.1, R701.1, U701.9 (A)
/Link Socket-2/RX-B: J701.2, R701.2, U701.8 (B)
/Link Socket-2/TX-Y: J701.3, U701.6 (Y)
/Link Socket-2/TX-Z: J701.6, U701.7 (Z)
/Socket-2-RX: U701.1 (R); also elsewhere on the board
/Socket-2-TX: U701.4 (D); also elsewhere on the board
/Socket-2-TX-Enable: U701.3 (DE); also elsewhere on the board
/Socket-Shield: J701.S; also elsewhere on the board
GND: C701.2, J701.7, J701.8, U701.2 (RE), U701.5 (GND), U701.11 (GND); also elsewhere on the board

Notes on the sheet:
PoE Passive +28V IEEE 802.3af Mode B
RS-422 3MHz

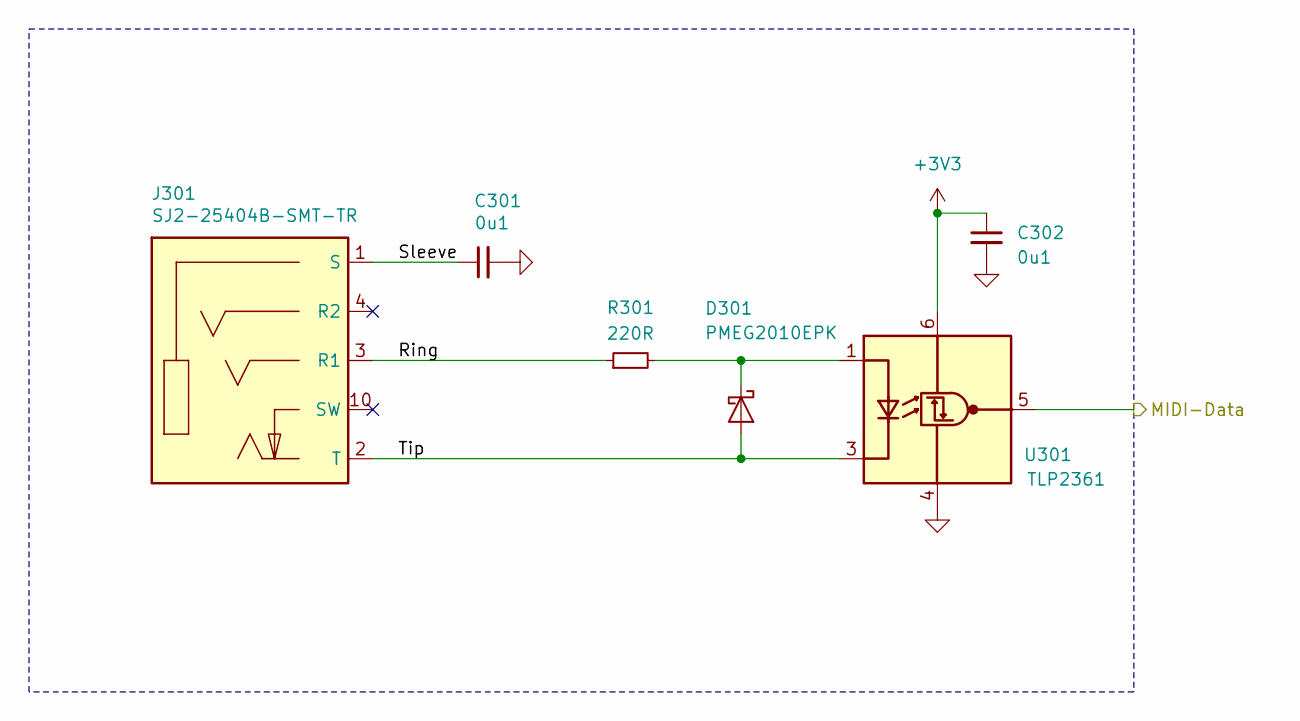
[picture p27: schematic MIDIIn.kicad_sch, V2 hub]

Parts:
C301, C302: 0u1; C_1608; Rating 50V; Mouser 810-CGA3E2X7R1H104MA
D301: PMEG2010EPK; D_SOD-1608; Rating 20V; Mouser 771-PMEG2010EPK
J301: SJ2-25404B-SMT-TR; CUI_SJ2-25404B-SMT-TR; Rating 2.5mm; Mouser 490-SJ2-25404BSMT-TR
R301: 220R; R_1608; Rating 330mW; Mouser 71-CRCW0603220RFKEAH
U301: TLP2361; SO-5-6_4.55x3.7mm_P1.27mm; Rating 15Mbps; Mouser 757-TLP2361TPRE

Connections:
+3V3: C302.1, U301.6 (VDD); also elsewhere on the board
/MIDI In/Ring: J301.3 (R1), R301.1
/MIDI In/Sleeve: C301.1, J301.1 (S)
/MIDI In/Tip: D301.2 (A), J301.2 (T), U301.3 (K)
/MIDI-In: U301.5 (VO); also elsewhere on the board
GND: C301.2, C302.2, U301.4 (GND); also elsewhere on the board
unnamed: D301.1 (K), R301.2, U301.1 (A)

Parts of its further copies:
C801, C802: 0u1; C_1608; Rating 50V; Mouser 810-CGA3E2X7R1H104MA
D801: PMEG2010EPK; D_SOD-1608; Rating 20V; Mouser 771-PMEG2010EPK
J801: SJ2-25404B-SMT-TR; CUI_SJ2-25404B-SMT-TR; Rating 2.5mm; Mouser 490-SJ2-25404BSMT-TR
R801: 220R; R_1608; Rating 330mW; Mouser 71-CRCW0603220RFKEAH
U801: TLP2361; SO-5-6_4.55x3.7mm_P1.27mm; Rating 15Mbps; Mouser 757-TLP2361TPRE

Connections of its further copies:
+3V3: C802.1, U801.6 (VDD); also elsewhere on the board
/MIDI In-2/Ring: J801.3 (R1), R801.1
/MIDI In-2/Sleeve: C801.1, J801.1 (S)
/MIDI In-2/Tip: D801.2 (A), J801.2 (T), U801.3 (K)
/MIDI-In-2: U801.5 (VO); also elsewhere on the board
GND: C801.2, C802.2, U801.4 (GND); also elsewhere on the board
unnamed: D801.1 (K), R801.2, U801.1 (A)

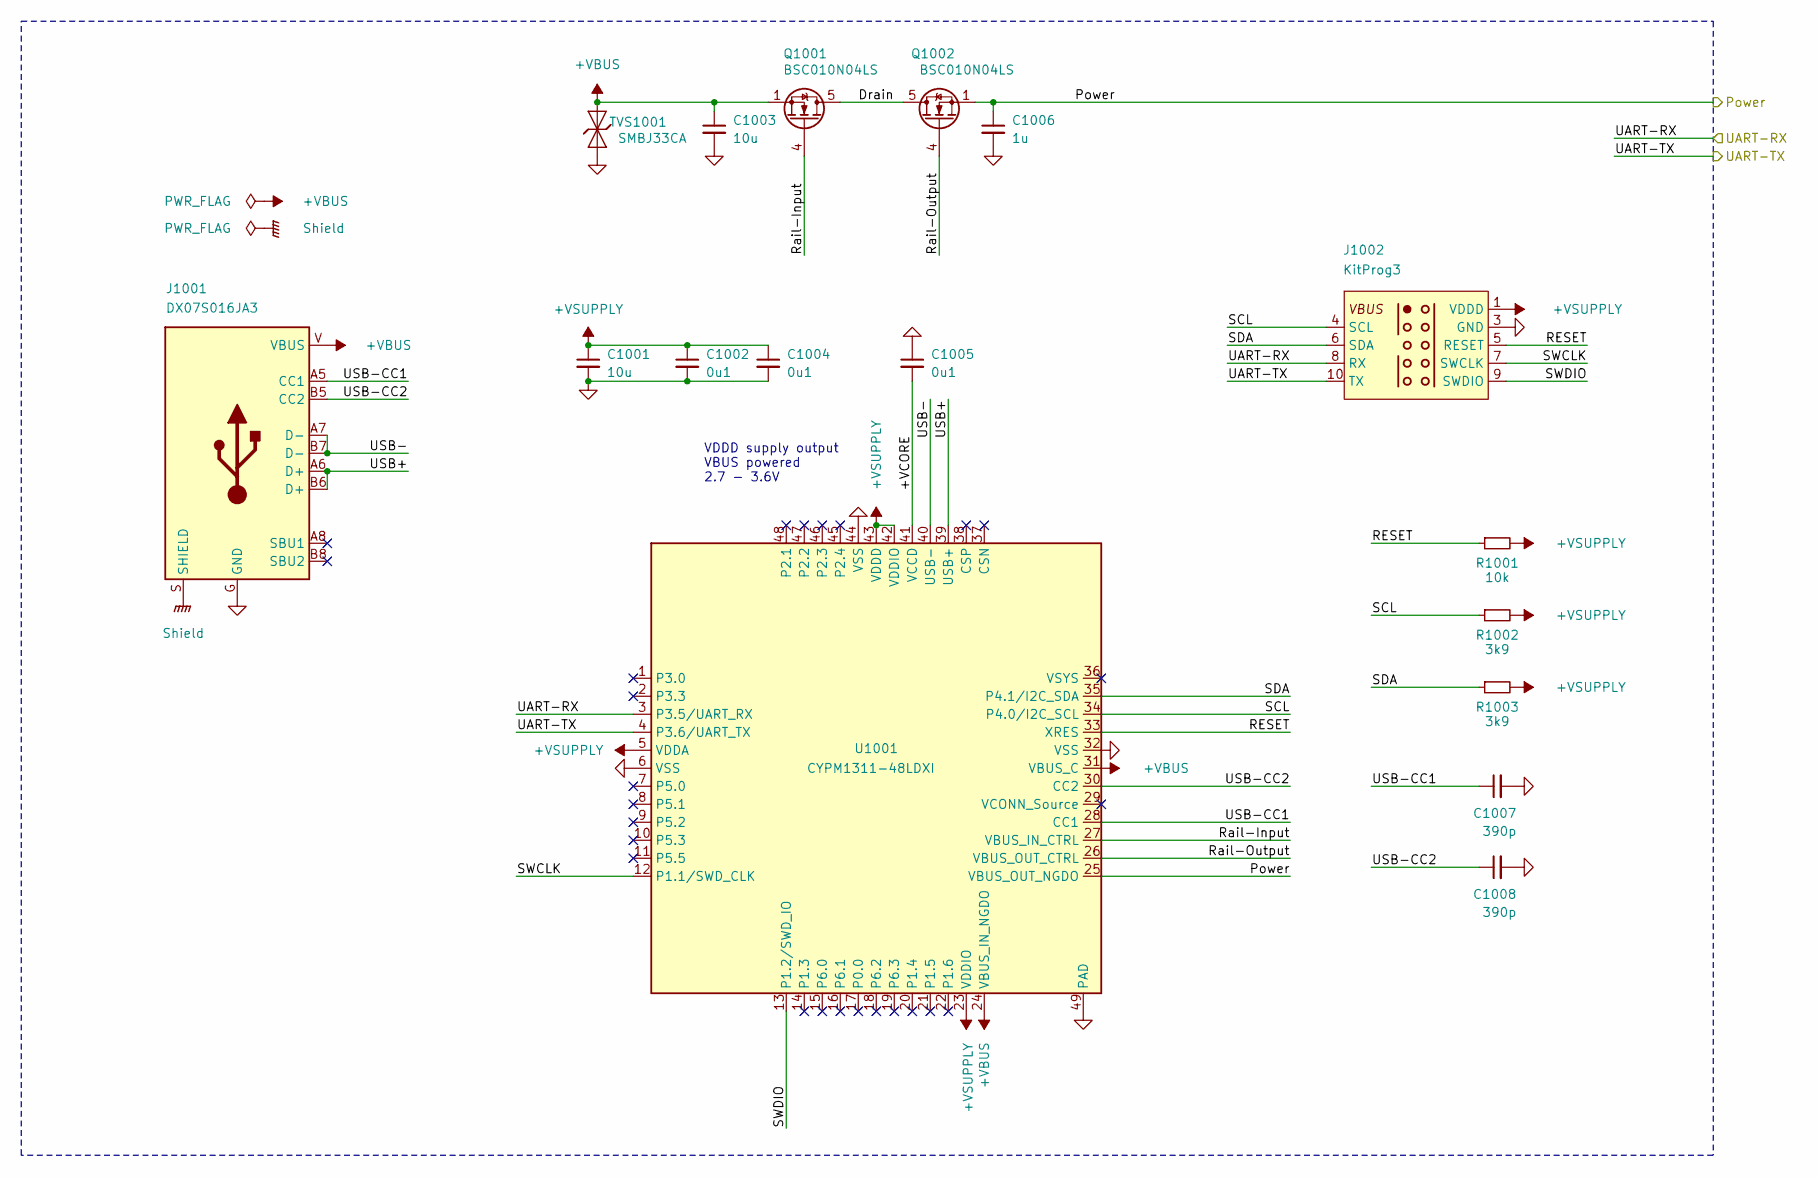
[picture p28: schematic PowerDelivery.kicad_sch, V2 hub]

Parts:
C1001: 10u; C_1608; Rating 10V; Mouser 810-C1608X6S1A106M
C1002, C1004, C1005: 0u1; C_1608; Rating 50V; Mouser 810-CGA3E2X7R1H104MA
C1003: 10u; C_2012; Rating 25V; Mouser 810-C2012X5R1E106K
C1006: 1u; C_1608; Rating 50V; Mouser 810-CGA3E3X7R1H105K0
C1007, C1008: 390p; C_1608; Rating 50V; Mouser 810-CGA3E2C0G1H391J
J1001: DX07S016JA3; JAE_DX07S016JA3; Rating USB2.0; Mouser 656-DX07S016JA3R1500
J1002: KitProg3
Q1001, Q1002: BSC010N04LS; TDSON-8-FL; Rating 40V; Mouser 726-BSC010N04LS
R1001: 10k; R_1608; Rating 100mW; Mouser 71-CRCW060310K0FKEAC
R1002, R1003: 3k9; R_1608; Rating 100mW; Mouser 71-CRCW06033K90FKEAC
TVS1001: SMBJ33CA; D_SMB; Rating 33V; Mouser 652-SMBJ33CA-Q
U1001: CYPM1311-48LDXI; QFN-48-1EP_6x6mm_P0.4mm_EP4.6x4.6mm; Rating 28V; Mouser 727-CYPM1311-48LDXI

Connections:
/+VLINK: C1006.1, Q1002.1 (S), U1001.25 (VBUS_OUT_NGDO); also elsewhere on the board
/PowerDelivery/+VBUS: C1003.1, J1001.V (VBUS), Q1001.1 (S), TVS1001.2 (A), U1001.24 (VBUS_IN_NGDO), U1001.31 (VBUS_C)
/PowerDelivery/+VCORE: C1005.2, U1001.41 (VCCD)
/PowerDelivery/+VSUPPLY: C1001.1, C1002.1, C1004.1, J1002.1 (VDDD), R1001.2, R1002.2, R1003.2, U1001.5 (VDDA), U1001.23 (VDDIO), U1001.42 (VDDIO), U1001.43 (VDDD)
/PowerDelivery/Drain: Q1001.5 (D), Q1002.5 (D)
/PowerDelivery/RESET: J1002.5 (RESET), R1001.1, U1001.33 (XRES)
/PowerDelivery/Rail-Input: Q1001.4 (G), U1001.27 (VBUS_IN_CTRL)
/PowerDelivery/Rail-Output: Q1002.4 (G), U1001.26 (VBUS_OUT_CTRL)
/PowerDelivery/SCL: J1002.4 (SCL), R1002.1, U1001.34 (P4.0/I2C_SCL)
/PowerDelivery/SDA: J1002.6 (SDA), R1003.1, U1001.35 (P4.1/I2C_SDA)
/PowerDelivery/SWCLK: J1002.7 (SWCLK), U1001.12 (P1.1/SWD_CLK)
/PowerDelivery/SWDIO: J1002.9 (SWDIO), U1001.13 (P1.2/SWD_IO)
/PowerDelivery/Shield: J1001.S (SHIELD)
/PowerDelivery/UART-RX: J1002.8 (RX), U1001.3 (P3.5/UART_RX)
/PowerDelivery/UART-TX: J1002.10 (TX), U1001.4 (P3.6/UART_TX)
/PowerDelivery/USB+: J1001.A6 (D+), J1001.B6 (D+), U1001.39 (USB+)
/PowerDelivery/USB-: J1001.A7 (D-), J1001.B7 (D-), U1001.40 (USB-)
/PowerDelivery/USB-CC1: C1007.1, J1001.A5 (CC1), U1001.28 (CC1)
/PowerDelivery/USB-CC2: C1008.1, J1001.B5 (CC2), U1001.30 (CC2)
GND: C1001.2, C1002.2, C1003.2, C1004.2, C1005.1, C1006.2, C1007.2, C1008.2, J1001.G (GND), J1002.3 (GND), TVS1001.1 (K), U1001.6 (VSS), U1001.32 (VSS), U1001.44 (VSS), U1001.49 (PAD); also elsewhere on the board

Notes on the sheet:
VDDD supply output VBUS powered 2.7 - 3.6V

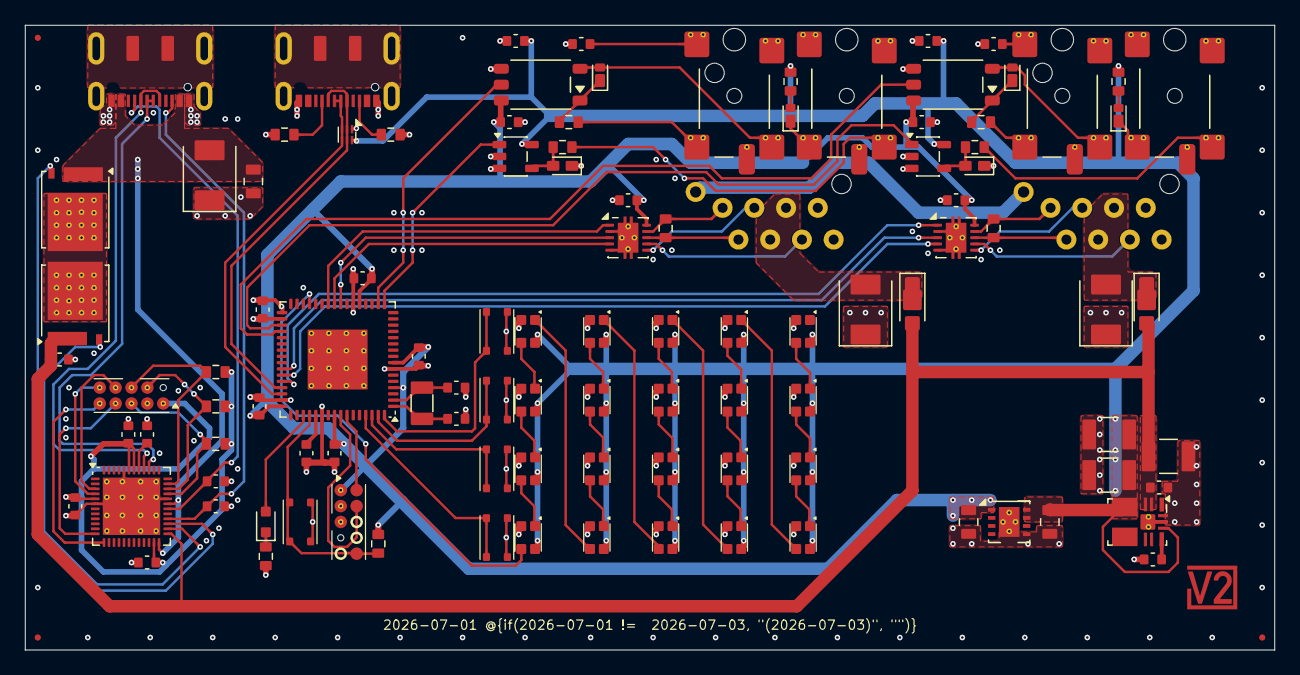
[picture p29: board hub.kicad_pcb from above]

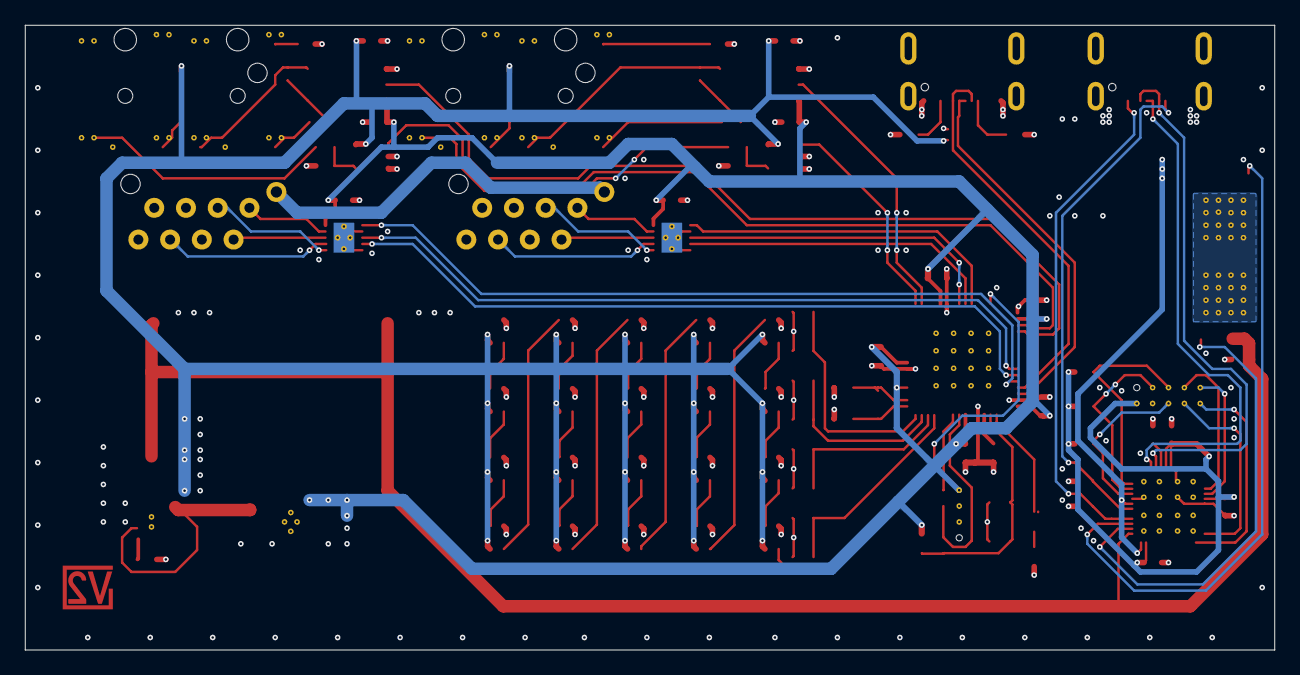
[picture p30: board hub.kicad_pcb from below]

Board: 4 copper layers, 100.0 x 50.0 mm, 113 parts (2 on the bottom side), 95 nets.
