versioduo/connect/hardware/plug/plug.kicad_pcb

## KiCad design hardware/plug/plug.kicad_pcb (2026-06-07)

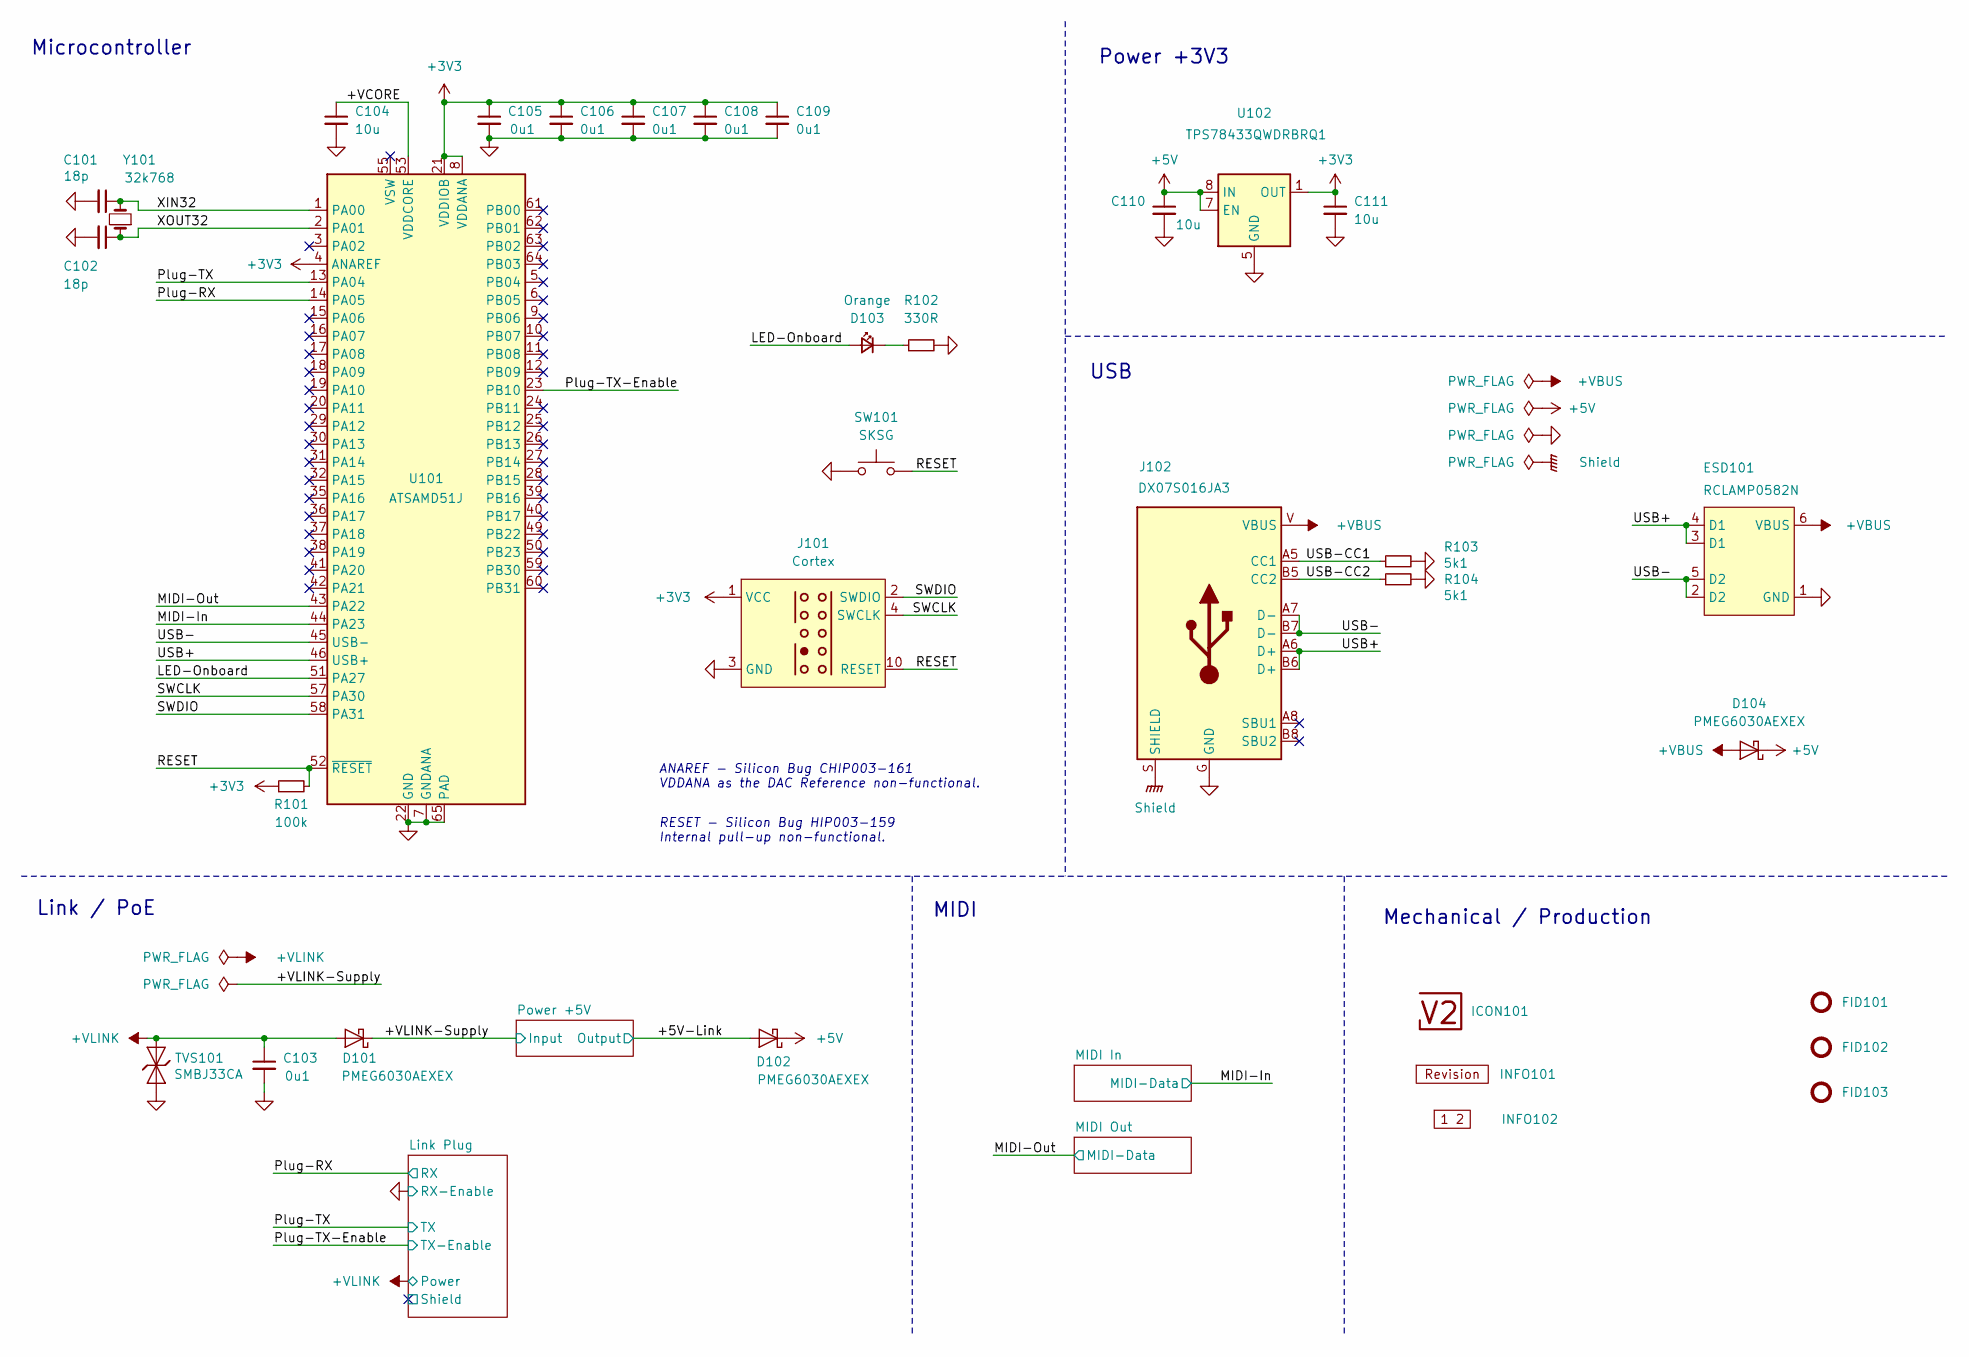
[picture p31: schematic plug.kicad_sch, V2 connect-plug]

Parts:
C101, C102: 18p; C_1608; Rating 50V; Mouser 810-CGA3E2C0G1H180J
C103, C105, C106, C107, C108, C109: 0u1; C_1608; Rating 50V; Mouser 810-CGA3E2X7R1H104MA
C104: 10u; C_1608; Rating 10V; Mouser 810-C1608X6S1A106M
C110, C111: 10u; C_2012; Rating 25V; Mouser 810-C2012X5R1E106K
D101, D102, D104: PMEG6030AEXEX; D_SOD-123HP; Rating 60V; Mouser 771-PMEG6030AEXEX
D103: Orange; LED_1608; Rating 605nm; Mouser 755-SML-D12D1WT86
ESD101: RCLAMP0582N; SLP1210N6; Rating 20kV; Mouser 947-RCLAMP0582N.TCT
FID101, FID102, FID103: Fiducial_Paste; Fiducial_0.5mm_Mask1mm_Paste
ICON101: V2-logo; Logo_Small
INFO101: Revision
INFO102: Layer_Numbers-4
J101: Cortex
J102: DX07S016JA3; JAE_DX07S016JA3; Rating USB2.0; Mouser 656-DX07S016JA3R1500
R101: 100k; R_1608; Rating 100mW; Mouser 71-CRCW0603100KFKEAC
R102: 330R; R_1608; Rating 100mW; Mouser 71-CRCW0603330RFKEAC
R103, R104: 5k1; R_1608; Rating 100mW; Mouser 71-CRCW06035K10FKEAC
SW101: SKSG; Rating 1.6N; Mouser 688-SKSGACE010
TVS101: SMBJ33CA; D_SMB; Rating 33V; Mouser 652-SMBJ33CA-Q
U101: ATSAMD51J; QFN-64-1EP_9x9mm_P0.5mm_EP4.8x4.8mm_ThermalVias; Rating Cortex-M4F; Mouser 556-ATSAMD51J19AMU
U102: TPS78433QWDRBRQ1; VSON-8-1_3x3mm_P0.65_EP1.65x2.4mm; Rating 300mA; Mouser 595-TPS78433QWDRBRQ1
Y101: 32k768; Crystal_SMD_3215-2Pin_3.2x1.5mm; Rating 10ppm; Mouser 815-ABS0716632.768KT

Connections:
+3V3: C105.1, C106.1, C107.1, C108.1, C109.1, C111.1, J101.1 (VCC), R101.1, U101.4 (ANAREF), U101.8 (VDDANA), U101.21 (VDDIOB), U101.34 (VDDIO), U101.48 (VDDIO), U101.56 (VDDIO), U102.1 (OUT); also elsewhere on the board
+5V: C110.1, D102.1 (K), D104.1 (K), U102.7 (EN), U102.8 (IN); also elsewhere on the board
/+5V-Link: D102.2 (A); also elsewhere on the board
/+VBUS: D104.2 (A), ESD101.6 (VBUS), J102.V (VBUS)
/+VCORE: C104.1, U101.53 (VDDCORE)
/+VLINK: C103.1, D101.2 (A), TVS101.2 (A); also elsewhere on the board
/+VLINK-Supply: D101.1 (K); also elsewhere on the board
/LED-Onboard: D103.2 (A), U101.51 (PA27)
/MIDI-In: U101.44 (PA23); also elsewhere on the board
/MIDI-Out: U101.43 (PA22); also elsewhere on the board
/Plug-RX: U101.14 (PA05); also elsewhere on the board
/Plug-TX: U101.13 (PA04); also elsewhere on the board
/Plug-TX-Enable: U101.23 (PB10); also elsewhere on the board
/RESET: J101.10 (RESET), R101.2, SW101.2, U101.52 (~RESET)
/SWCLK: J101.4 (SWCLK), U101.57 (PA30)
/SWDIO: J101.2 (SWDIO), U101.58 (PA31)
/Shield: J102.S (SHIELD)
/USB+: ESD101.3 (D1), ESD101.4 (D1), J102.A6 (D+), J102.B6 (D+), U101.46 (USB+)
/USB-: ESD101.2 (D2), ESD101.5 (D2), J102.A7 (D-), J102.B7 (D-), U101.45 (USB-)
/USB-CC1: J102.A5 (CC1), R103.1
/USB-CC2: J102.B5 (CC2), R104.1
/XIN32: C101.1, U101.1 (PA00), Y101.2
/XOUT32: C102.1, U101.2 (PA01), Y101.1
GND: C101.2, C102.2, C103.2, C104.2, C105.2, C106.2, C107.2, C108.2, C109.2, C110.2, C111.2, ESD101.1 (GND), J101.3 (GND), J101.5 (GND), J102.G (GND), R102.2, R103.2, R104.2, SW101.1, TVS101.1 (K), U101.7 (GNDANA), U101.22 (GND), U101.33 (GND), U101.47 (GND), U101.54 (GND), U101.65 (PAD), U102.5 (GND), U102.9 (GND); also elsewhere on the board
unnamed: D103.1 (K), R102.1

Notes on the sheet:
ANAREF - Silicon Bug CHIP003-161 VDDANA as the DAC Reference non-functional.
Link / PoE
RESET - Silicon Bug HIP003-159 Internal pull-up non-functional.
MIDI
Power +3V3
Mechanical / Production
Microcontroller
USB

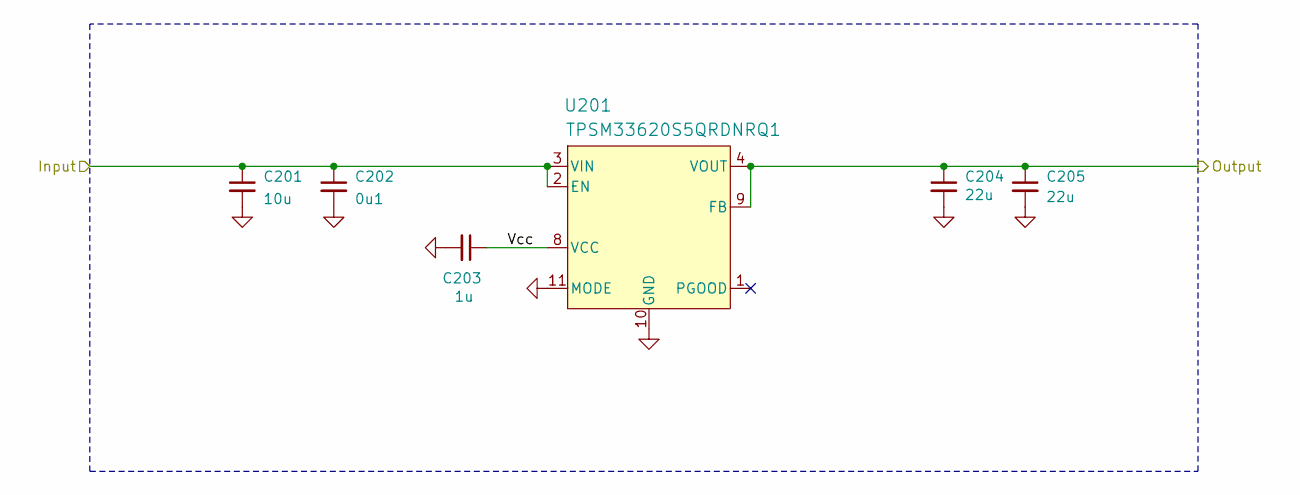
[picture p32: schematic PowerSupply.kicad_sch, V2 connect-plug]

Parts:
C201: 10u; C_3225; Rating 50V; Mouser 810-CNC6P1X7R1H106K2
C202: 0u1; C_1608; Rating 50V; Mouser 810-CGA3E2X7R1H104MA
C203: 1u; C_1608; Rating 50V; Mouser 810-CGA3E3X7R1H105K0
C204, C205: 22u; C_3225; Rating 25V; Mouser 810-CGA6P3X7R1E226M5
U201: TPSM33620S5QRDNRQ1; QFN-11; Rating 2A; Mouser 595-SM33620S5QRDNRQ1

Connections:
/+5V-Link: C204.1, C205.1, U201.4 (VOUT), U201.9 (FB); also elsewhere on the board
/+VLINK-Supply: C201.1, C202.1, U201.2 (EN), U201.3 (VIN); also elsewhere on the board
/Power +5V/Vcc: C203.1, U201.8 (VCC)
GND: C201.2, C202.2, C203.2, C204.2, C205.2, U201.10 (GND), U201.11 (MODE); also elsewhere on the board

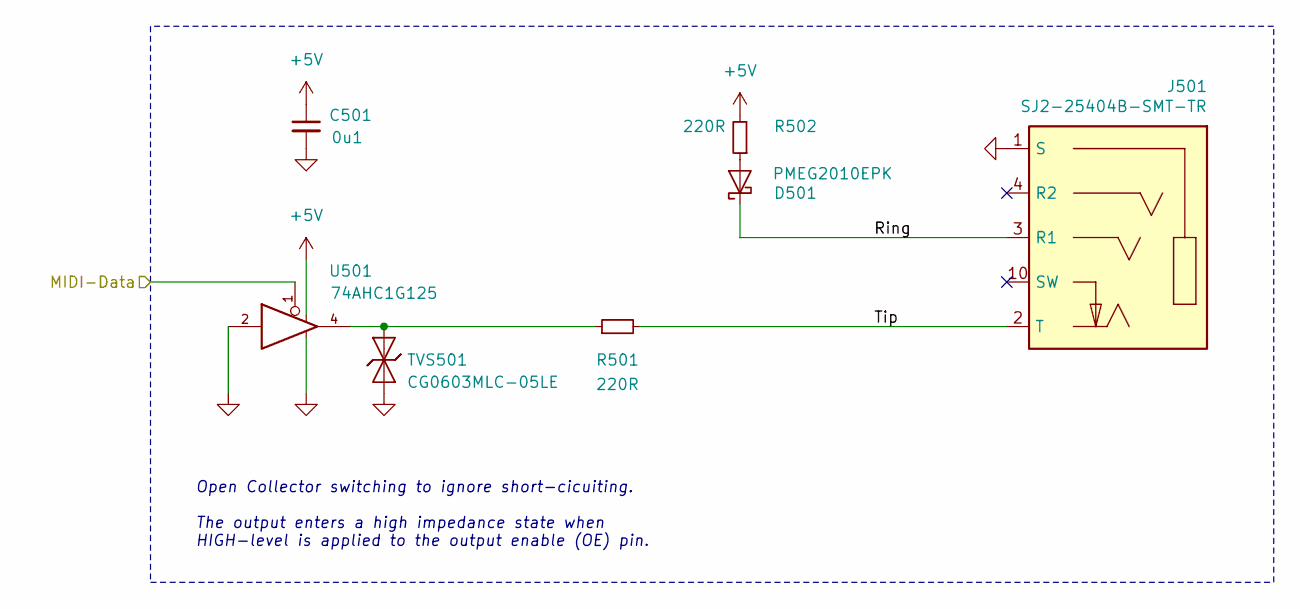
[picture p33: schematic MIDIOut.kicad_sch, V2 connect-plug]

Parts:
C501: 0u1; C_1608; Rating 50V; Mouser 810-CGA3E2X7R1H104MA
D501: PMEG2010EPK; D_SOD-1608; Rating 20V; Mouser 771-PMEG2010EPK
J501: SJ2-25404B-SMT-TR; CUI_SJ2-25404B-SMT-TR; Rating 2.5mm; Mouser 490-SJ2-25404BSMT-TR
R501, R502: 220R; R_1608; Rating 330mW; Mouser 71-CRCW0603220RFKEAH
TVS501: CG0603MLC-05LE; D_1608; Rating 5V; Mouser 652-CG0603MLC-05LE
U501: 74AHC1G125; SOT-23-5; Rating 8mA; Mouser 595-SN74AHC1G125DBVR

Connections:
+5V: C501.1, R502.2, U501.5; also elsewhere on the board
/MIDI Out/Ring: D501.1 (K), J501.3 (R1)
/MIDI Out/Tip: J501.2 (T), R501.2
/MIDI-Out: U501.1; also elsewhere on the board
GND: C501.2, J501.1 (S), TVS501.1 (K), U501.2, U501.3; also elsewhere on the board
unnamed: D501.2 (A), R502.1
unnamed: R501.1, TVS501.2 (A), U501.4

Notes on the sheet:
 Open Collector switching to ignore short-cicuiting. The output enters a high impedance state when HIGH-level is applied to the output enable (OE) pin.

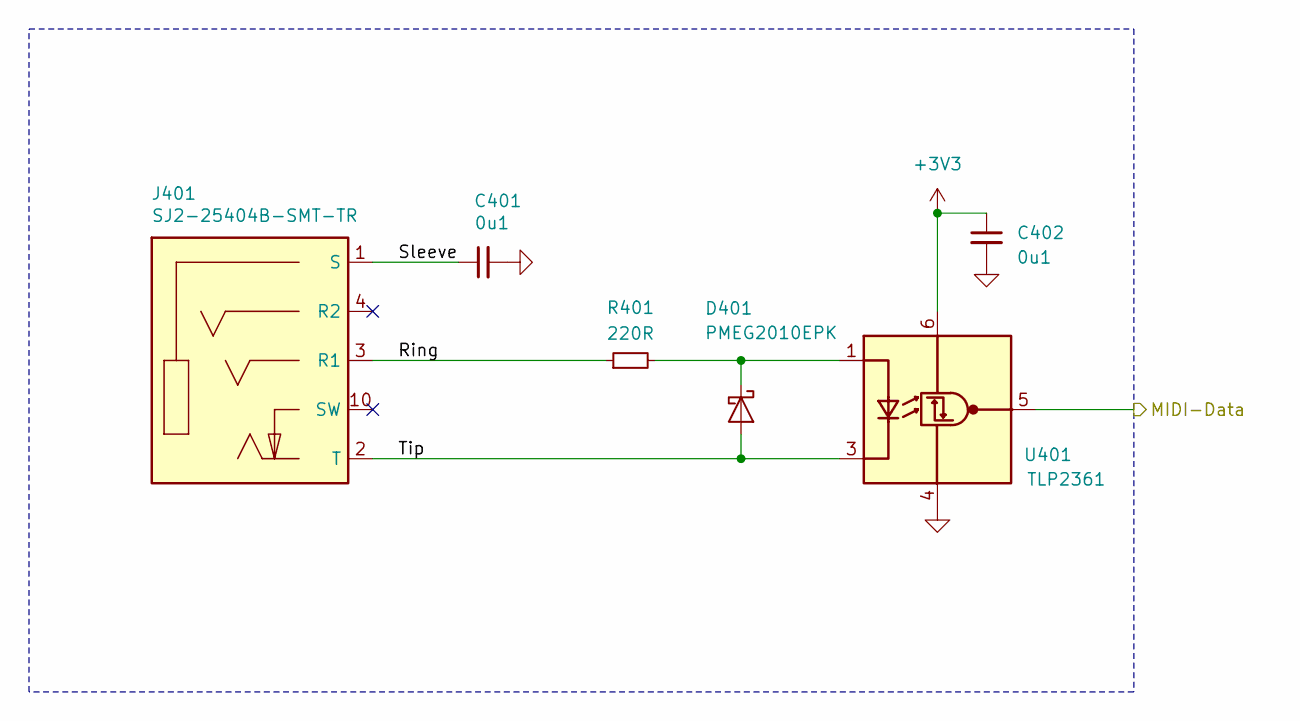
[picture p34: schematic MIDIIn.kicad_sch, V2 connect-plug]

Parts:
C401, C402: 0u1; C_1608; Rating 50V; Mouser 810-CGA3E2X7R1H104MA
D401: PMEG2010EPK; D_SOD-1608; Rating 20V; Mouser 771-PMEG2010EPK
J401: SJ2-25404B-SMT-TR; CUI_SJ2-25404B-SMT-TR; Rating 2.5mm; Mouser 490-SJ2-25404BSMT-TR
R401: 220R; R_1608; Rating 330mW; Mouser 71-CRCW0603220RFKEAH
U401: TLP2361; SO-5-6_4.55x3.7mm_P1.27mm; Rating 15Mbps; Mouser 757-TLP2361TPRE

Connections:
+3V3: C402.1, U401.6 (VDD); also elsewhere on the board
/MIDI In/Ring: J401.3 (R1), R401.1
/MIDI In/Sleeve: C401.1, J401.1 (S)
/MIDI In/Tip: D401.2 (A), J401.2 (T), U401.3 (K)
/MIDI-In: U401.5 (VO); also elsewhere on the board
GND: C401.2, C402.2, U401.4 (GND); also elsewhere on the board
unnamed: D401.1 (K), R401.2, U401.1 (A)

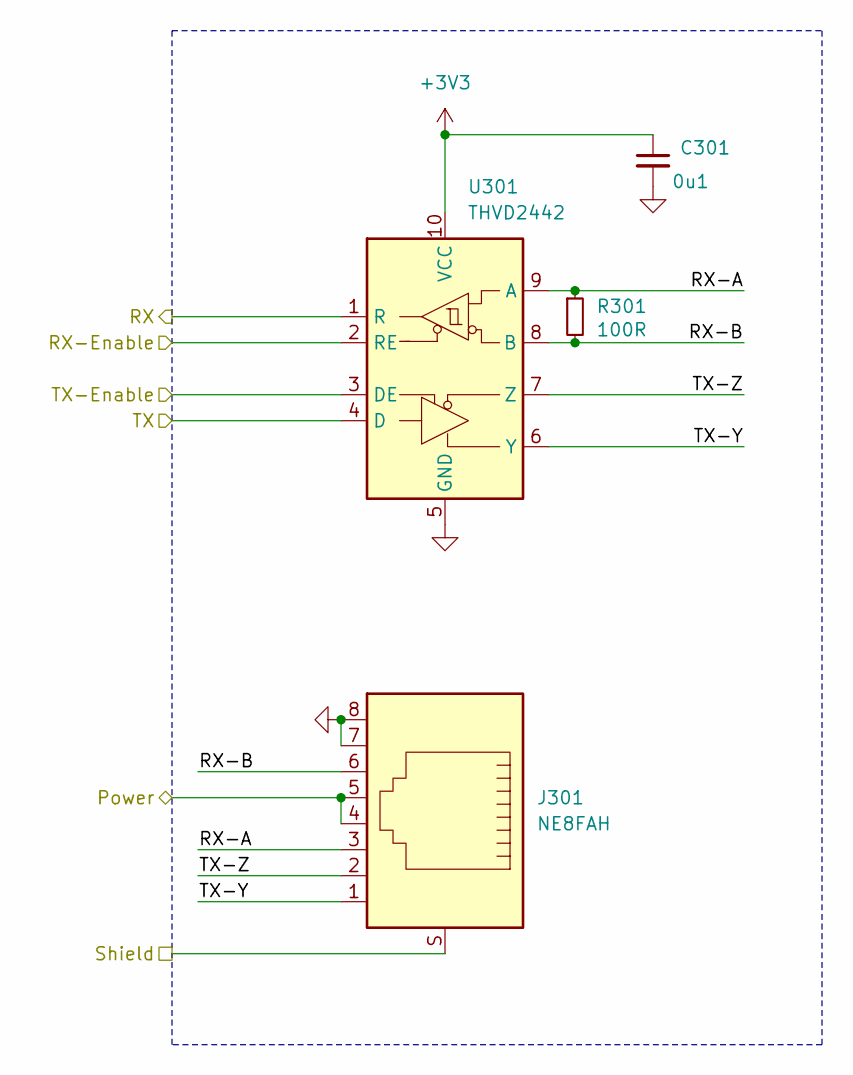
[picture p35: schematic LinkPlug.kicad_sch, V2 connect-plug]

Parts:
C301: 0u1; C_1608; Rating 50V; Mouser 810-CGA3E2X7R1H104MA
J301: NE8FAH; Rating CAT5e; Mouser 568-NE8FAH
R301: 100R; R_1608; Rating 330mW; Mouser 71-CRCW0603100RFKEAH
U301: THVD2442; VSON-10-4-1EP_3x3mm_P0.5mm_EP1.65x2.4mm_ThermalVias; Rating 20Mbps; Mouser 595-THVD2442DRCR

Connections:
+3V3: C301.1, U301.10 (VCC); also elsewhere on the board
/+VLINK: J301.4, J301.5; also elsewhere on the board
/Link Plug/RX-A: J301.3, R301.1, U301.9 (A)
/Link Plug/RX-B: J301.6, R301.2, U301.8 (B)
/Link Plug/Shield: J301.S
/Link Plug/TX-Y: J301.1, U301.6 (Y)
/Link Plug/TX-Z: J301.2, U301.7 (Z)
/Plug-RX: U301.1 (R); also elsewhere on the board
/Plug-TX: U301.4 (D); also elsewhere on the board
/Plug-TX-Enable: U301.3 (DE); also elsewhere on the board
GND: C301.2, J301.7, J301.8, U301.2 (RE), U301.5 (GND), U301.11 (GND); also elsewhere on the board

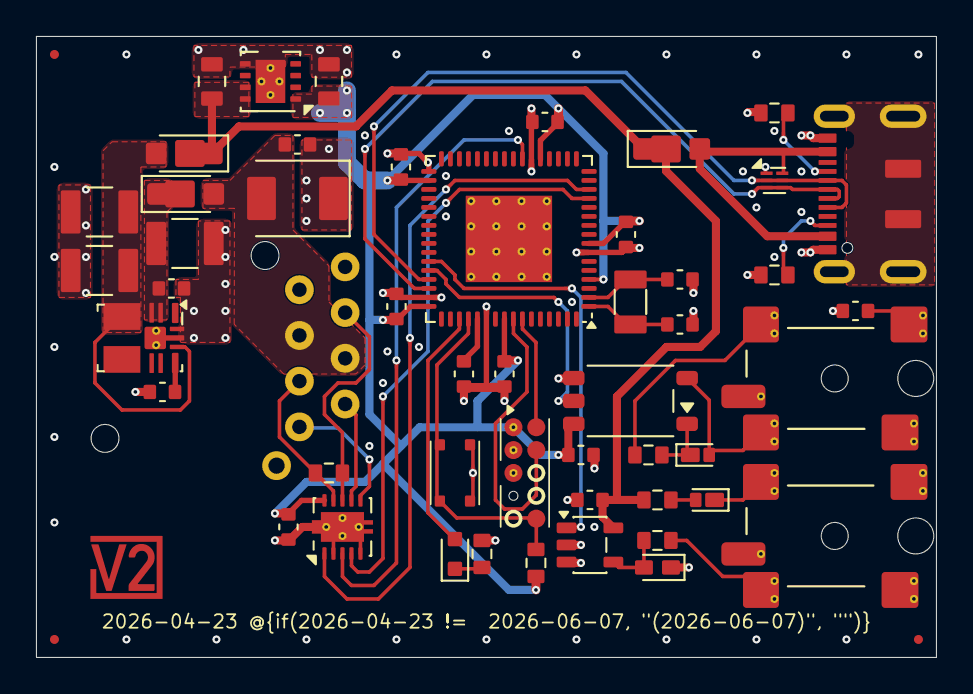
[picture p36: board plug.kicad_pcb from above]

Board: 4 copper layers, 50.0 x 34.5 mm, 56 parts (1 on the bottom side), 37 nets.
