versioduo/connect/(commit log)

2026-02-01 Update library
    [MIDIIn.kicad_sch, PowerSupply.kicad_sch, connect.kicad_pcb, connect.kicad_sch]
2026-02-10 Use date as revision
    [connect.kicad_pcb]
2026-02-13 Replace Order_Number
    [LinkSocket.kicad_sch, MIDIIn.kicad_sch, MIDIOut.kicad_sch, connect.kicad_pcb, connect.kicad_sch]
2026-03-02 Export stencil
    [PowerSupply.kicad_sch, connect.kicad_pcb, connect.kicad_sch]
2026-03-12 Replace diode
    [LinkSocket.kicad_sch, MIDIIn.kicad_sch, MIDIOut.kicad_sch, PowerSupply.kicad_sch, connect.kicad_pcb, connect.kicad_sch]
2026-03-14 Update ESD suppressor
    [MIDIOut.kicad_sch, connect.kicad_pcb, connect.kicad_sch]
2026-03-21 KiCad 10
    [LEDs.kicad_sch, LinkSocket.kicad_sch, MIDIIn.kicad_sch, MIDIOut.kicad_sch, PowerSupply.kicad_sch, connect.kicad_pcb, connect.kicad_sch]
2026-03-29 Update Revision footprint
    [LEDs.kicad_sch, LinkSocket.kicad_sch, MIDIIn.kicad_sch, MIDIOut.kicad_sch, PowerSupply.kicad_sch, connect.kicad_pcb, connect.kicad_sch]
2026-03-31 Replace step-down
    [PowerSupply.kicad_sch, connect.kicad_pcb]
2026-04-23 Split into socket and plug
    [LEDs.kicad_sch, LinkPlug.kicad_sch, LinkSocket.kicad_sch, MIDIIn.kicad_sch, MIDIOut.kicad_sch, PowerSupply.kicad_sch, plug.kicad_pcb, plug.kicad_sch]
2026-04-24 Update DRC
    [plug.kicad_pcb]
2026-05-11 Good Bye Imperial
    [LEDs.kicad_sch, LinkPlug.kicad_sch, LinkSocket.kicad_sch, MIDIIn.kicad_sch, MIDIOut.kicad_sch, PowerSupply.kicad_sch, plug.kicad_pcb, plug.kicad_sch]
2026-05-19 Add connect-socket firmware
2026-05-22 connect-socket: CC LED splash
2026-08-01 Add hub
    [LEDs.kicad_sch, LinkSocket.kicad_sch, MIDIIn.kicad_sch, MIDIOut.kicad_sch, PowerDelivery.kicad_sch, PowerSupply.kicad_sch, hub.kicad_pcb, hub.kicad_sch]
2026-08-02 Add LED config
2026-08-07 Disable USB port config
    [hub.kicad_sch]
